kratz9/Scoreboard/Docs/System Overview.png

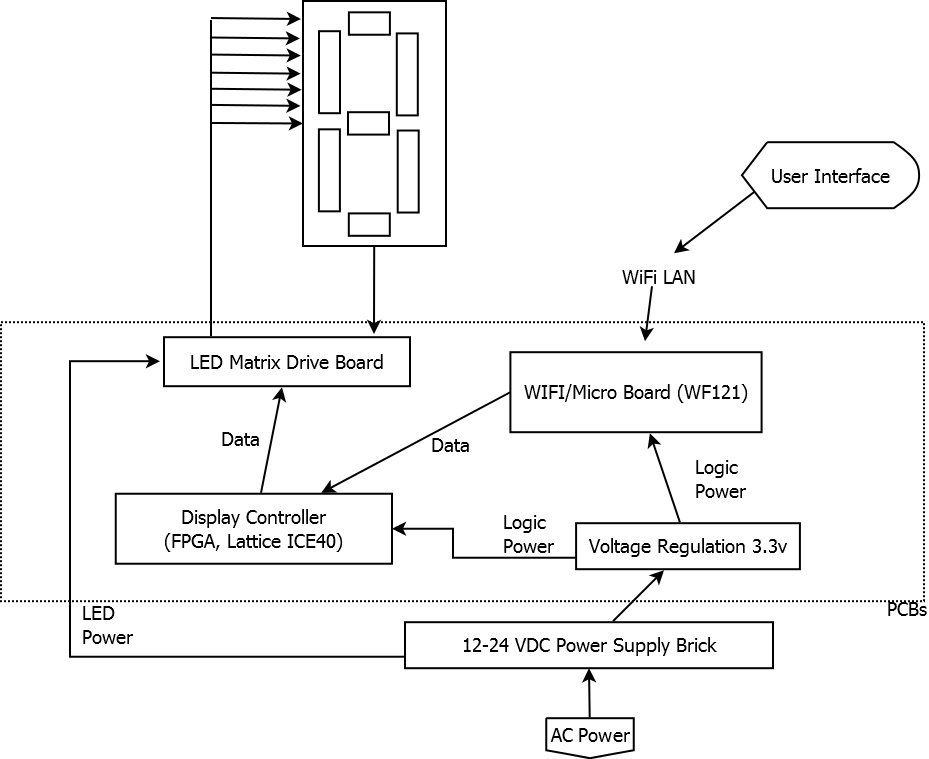
Docs/System Overview.png
