kratz9/Scoreboard/TestDisplay/TestDisplay.pdf

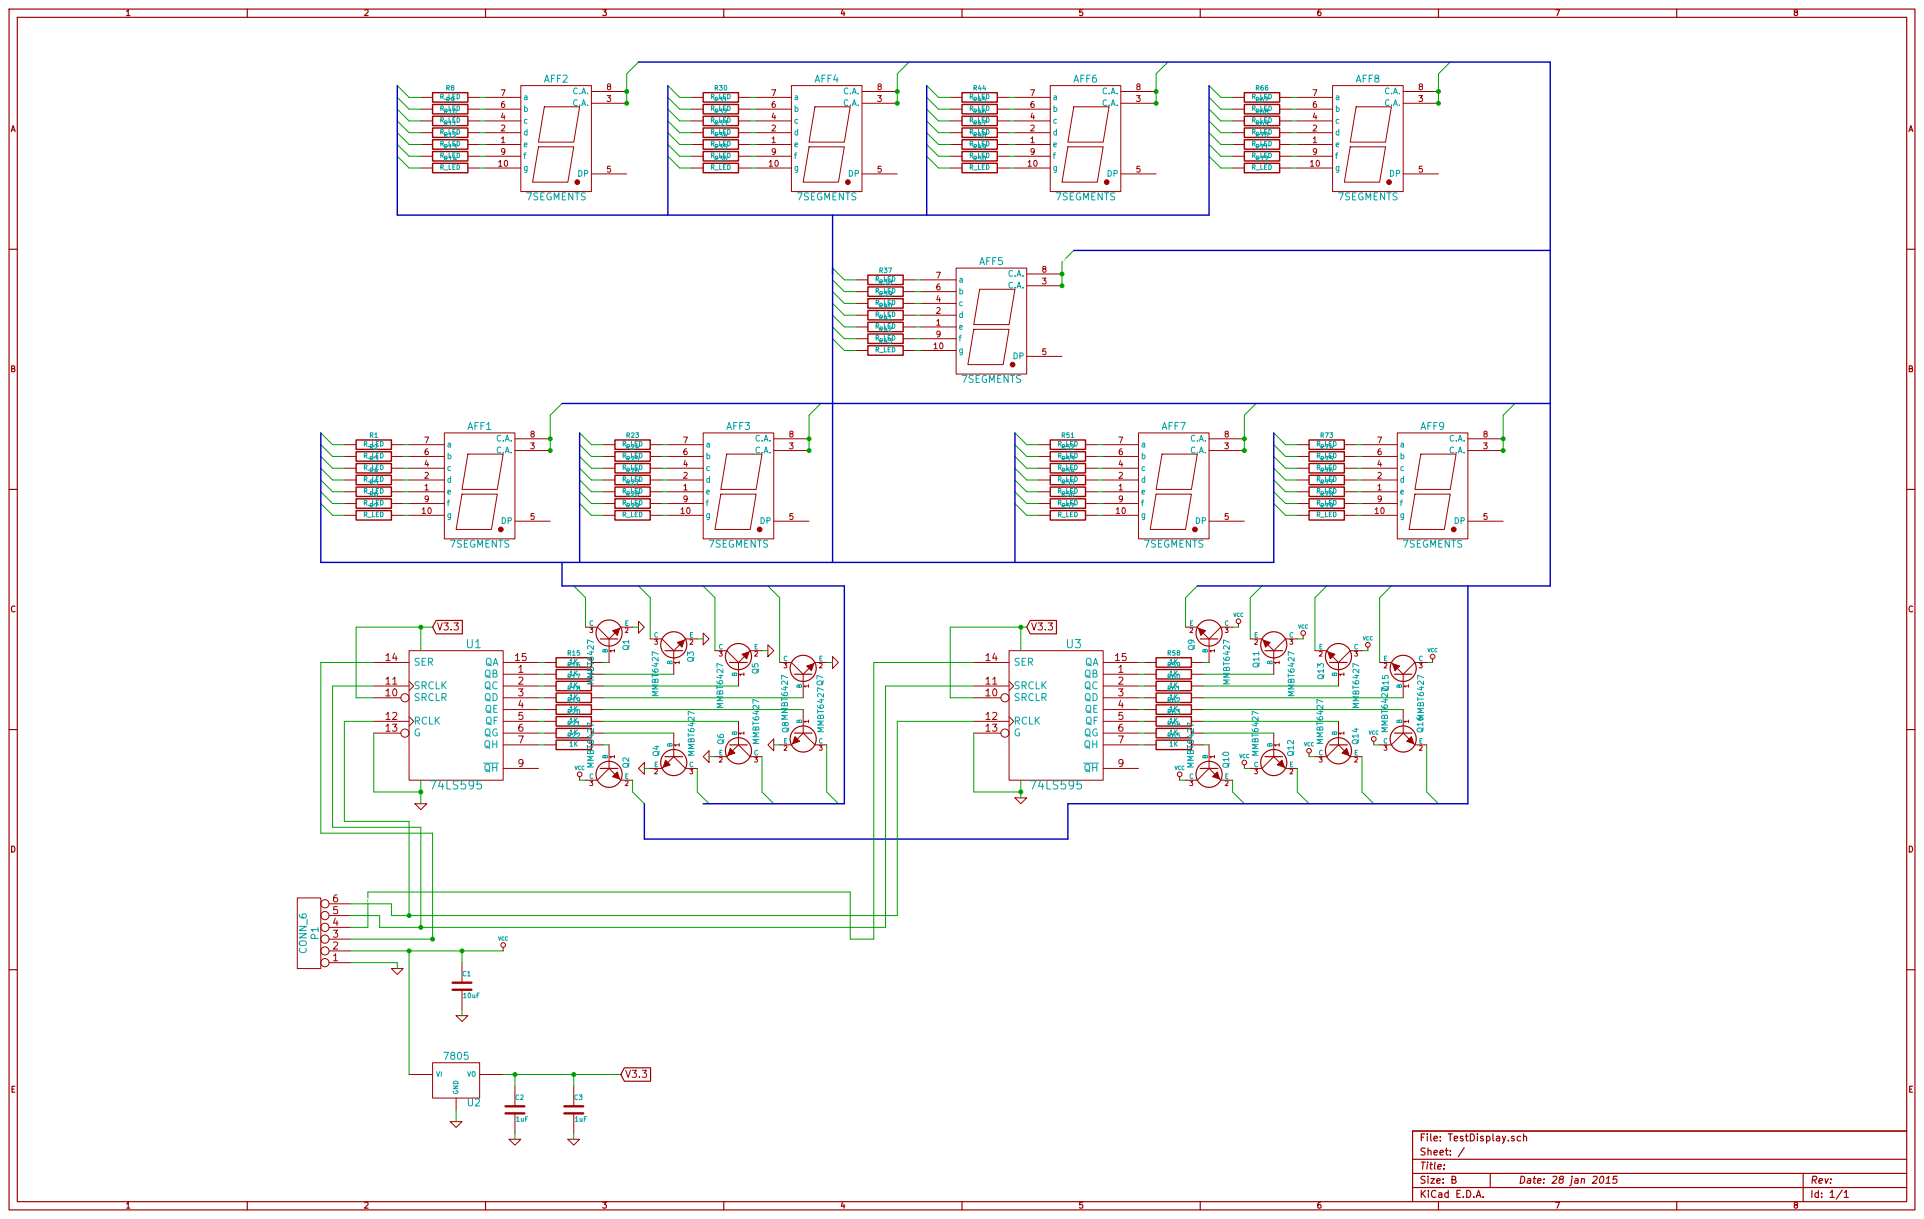
[picture p2: page 1]

Id: 1/1 Title: File: TestDisplay.sch
Sheet: /
