kratz9/Scoreboard/TestDigit/Digit.kicad_pcb

## KiCad design TestDigit/Digit.kicad_pcb (2015-02-24)

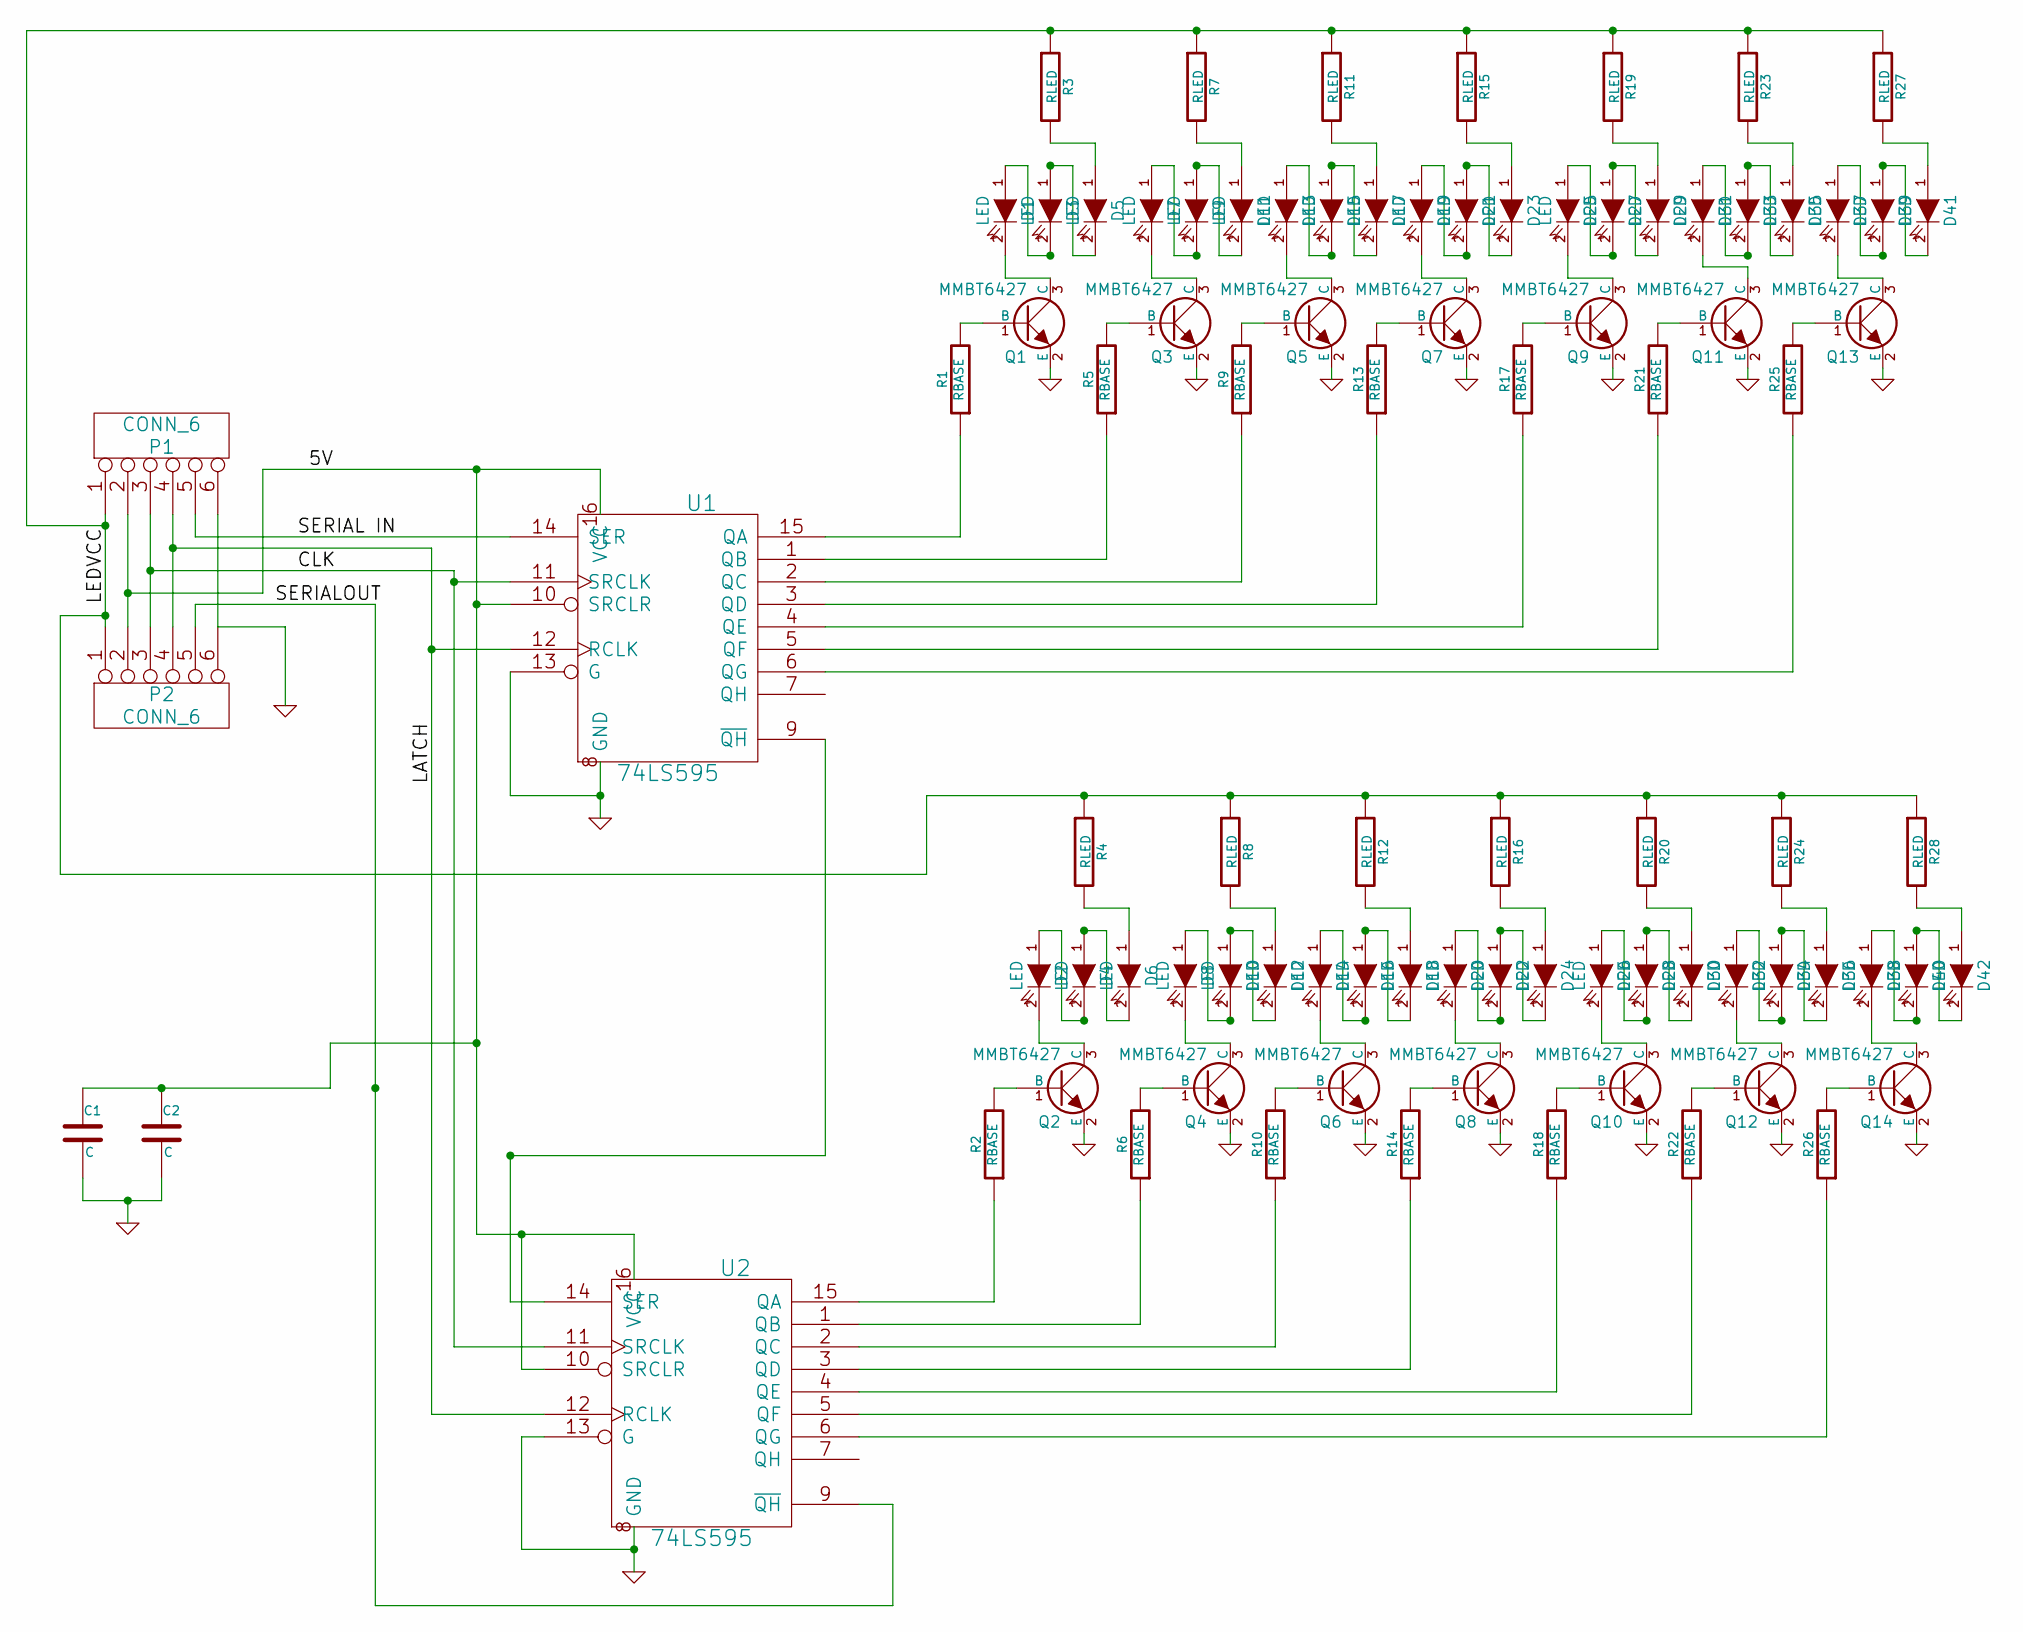
[picture p3: schematic Digit.sch]

Parts:
C1, C2: C
D1, D2, D3, D4, D5, D6, D7, D8, D9, D10, D11, D12, D13, D14, D15, D16, D17, D18, D19, D20, D21, D22, D23, D24, D25, D26, D27, D28, D29, D30, D31, D32, D33, D34, D35, D36, D37, D38, D39, D40, D41, D42: LED
P1, P2: CONN_6
Q1, Q2, Q3, Q4, Q5, Q6, Q7, Q8, Q9, Q10, Q11, Q12, Q13, Q14: MMBT6427
R1, R2, R5, R6, R9, R10, R13, R14, R17, R18, R21, R22, R25, R26: RBASE
R3, R4, R7, R8, R11, R12, R15, R16, R19, R20, R23, R24, R27, R28: RLED
U1, U2: 74LS595

Connections:
/5V: C1.1, C2.1, P1.2, P2.2, U1.10 (SRCLR), U1.16 (VCC), U2.10 (SRCLR), U2.16 (VCC)
/CLK: P1.3, P2.3, U1.11 (SRCLK), U2.11 (SRCLK)
/LATCH: P1.4, P2.4, U1.12 (RCLK), U2.12 (RCLK)
/LEDVCC: P1.1, P2.1, R3.1, R4.1, R7.1, R8.1, R11.1, R12.1, R15.1, R16.1, R19.1, R20.1, R23.1, R24.1, R27.1, R28.1
/SERIAL IN: P1.5, U1.14 (SER)
/SERIALOUT: P2.5, U2.9 (~QH)
GND: C1.2, C2.2, P1.6, P2.6, Q1.2 (E), Q2.2 (E), Q3.2 (E), Q4.2 (E), Q5.2 (E), Q6.2 (E), Q7.2 (E), Q8.2 (E), Q9.2 (E), Q10.2 (E), Q11.2 (E), Q12.2 (E), Q13.2 (E), Q14.2 (E), U1.8 (GND), U1.13 (G), U2.8 (GND), U2.13 (G)
unnamed: U1.9 (~QH), U2.14 (SER)
unnamed: D33.1 (A), D35.2 (K)
unnamed: D39.1 (A), D41.2 (K)
unnamed: Q2.1 (B), R2.2
unnamed: Q4.1 (B), R6.2
unnamed: Q6.1 (B), R10.2
unnamed: Q8.1 (B), R14.2
unnamed: D3.1 (A), D5.2 (K)
unnamed: R13.1, U1.3 (QD)
unnamed: R17.1, U1.4 (QE)
unnamed: R21.1, U1.5 (QF)
unnamed: R25.1, U1.6 (QG)
unnamed: Q10.1 (B), R18.2
unnamed: D7.1 (A), D9.2 (K)
unnamed: D9.1 (A), D11.2 (K)
unnamed: D15.1 (A), D17.2 (K)
unnamed: D21.1 (A), D23.2 (K)
unnamed: D27.1 (A), D29.2 (K)
unnamed: D16.1 (A), D18.2 (K)
unnamed: D22.1 (A), D24.2 (K)
unnamed: R26.1, U2.6 (QG)
unnamed: D28.1 (A), D30.2 (K)
unnamed: D34.1 (A), D36.2 (K)
unnamed: D40.1 (A), D42.2 (K)
unnamed: R10.1, U2.2 (QC)
unnamed: Q12.1 (B), R22.2
unnamed: Q14.1 (B), R26.2
unnamed: R2.1, U2.15 (QA)
unnamed: R6.1, U2.1 (QB)
unnamed: R14.1, U2.3 (QD)
unnamed: R18.1, U2.4 (QE)
unnamed: R22.1, U2.5 (QF)
unnamed: D10.1 (A), D12.2 (K)
unnamed: D12.1 (A), R8.2
unnamed: D14.2 (K), Q6.3 (C)
unnamed: D14.1 (A), D16.2 (K)
unnamed: D18.1 (A), R12.2
unnamed: D20.2 (K), Q8.3 (C)
unnamed: D20.1 (A), D22.2 (K)
unnamed: D4.1 (A), D6.2 (K)
unnamed: D41.1 (A), R27.2
unnamed: D2.2 (K), Q2.3 (C)
unnamed: D2.1 (A), D4.2 (K)
unnamed: D6.1 (A), R4.2
unnamed: D8.2 (K), Q4.3 (C)
unnamed: D8.1 (A), D10.2 (K)
unnamed: D38.2 (K), Q14.3 (C)
unnamed: D32.1 (A), D34.2 (K)
unnamed: D36.1 (A), R24.2
unnamed: D38.1 (A), D40.2 (K)
unnamed: D42.1 (A), R28.2
unnamed: D26.1 (A), D28.2 (K)
unnamed: D24.1 (A), R16.2
unnamed: D26.2 (K), Q10.3 (C)
unnamed: D30.1 (A), R20.2
unnamed: D32.2 (K), Q12.3 (C)
unnamed: D13.1 (A), D15.2 (K)
unnamed: D11.1 (A), R7.2
unnamed: D13.2 (K), Q5.3 (C)
unnamed: D17.1 (A), R11.2
unnamed: D19.2 (K), Q7.3 (C)
unnamed: D1.2 (K), Q1.3 (C)
unnamed: D1.1 (A), D3.2 (K)
unnamed: D19.1 (A), D21.2 (K)
unnamed: D5.1 (A), R3.2
unnamed: D7.2 (K), Q3.3 (C)
unnamed: D35.1 (A), R23.2
unnamed: D31.2 (K), Q11.3 (C)
unnamed: D31.1 (A), D33.2 (K)
unnamed: D37.2 (K), Q13.3 (C)
unnamed: D37.1 (A), D39.2 (K)
unnamed: D25.2 (K), Q9.3 (C)
unnamed: D23.1 (A), R15.2
unnamed: D25.1 (A), D27.2 (K)
unnamed: D29.1 (A), R19.2
unnamed: Q3.1 (B), R5.2
unnamed: Q5.1 (B), R9.2
unnamed: R9.1, U1.2 (QC)
unnamed: R1.1, U1.15 (QA)
unnamed: Q1.1 (B), R1.2
unnamed: Q13.1 (B), R25.2
unnamed: Q7.1 (B), R13.2
unnamed: Q9.1 (B), R17.2
unnamed: Q11.1 (B), R21.2
unnamed: R5.1, U1.1 (QB)

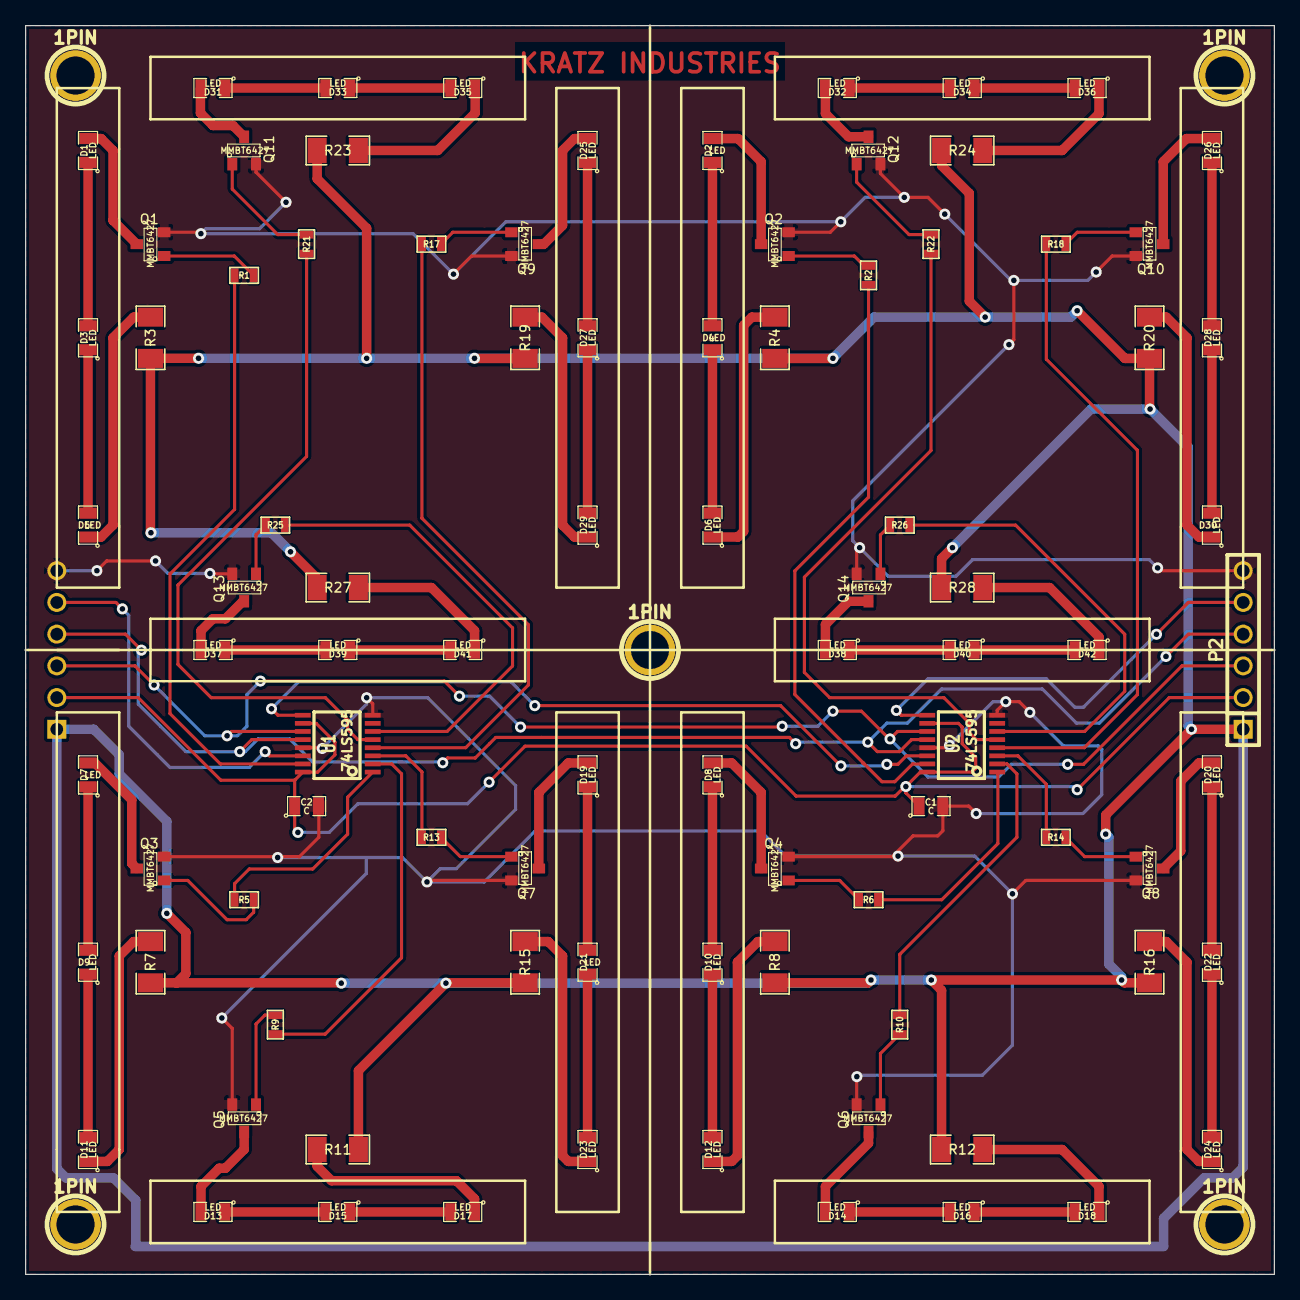
[picture p4: board Digit.kicad_pcb from above]

Board: 2 copper layers, 100.0 x 100.0 mm, 95 parts (1 on the bottom side), 92 nets.

Other parts of the board:
1PIN, 1PIN#2, 1PIN#3, 1PIN#4, 1PIN#5: P***; 1pin
