kratz9/Scoreboard/LED Drive/LED Drive.kicad_pcb

## KiCad design LED Drive/LED Drive.kicad_pcb (2015-02-01)

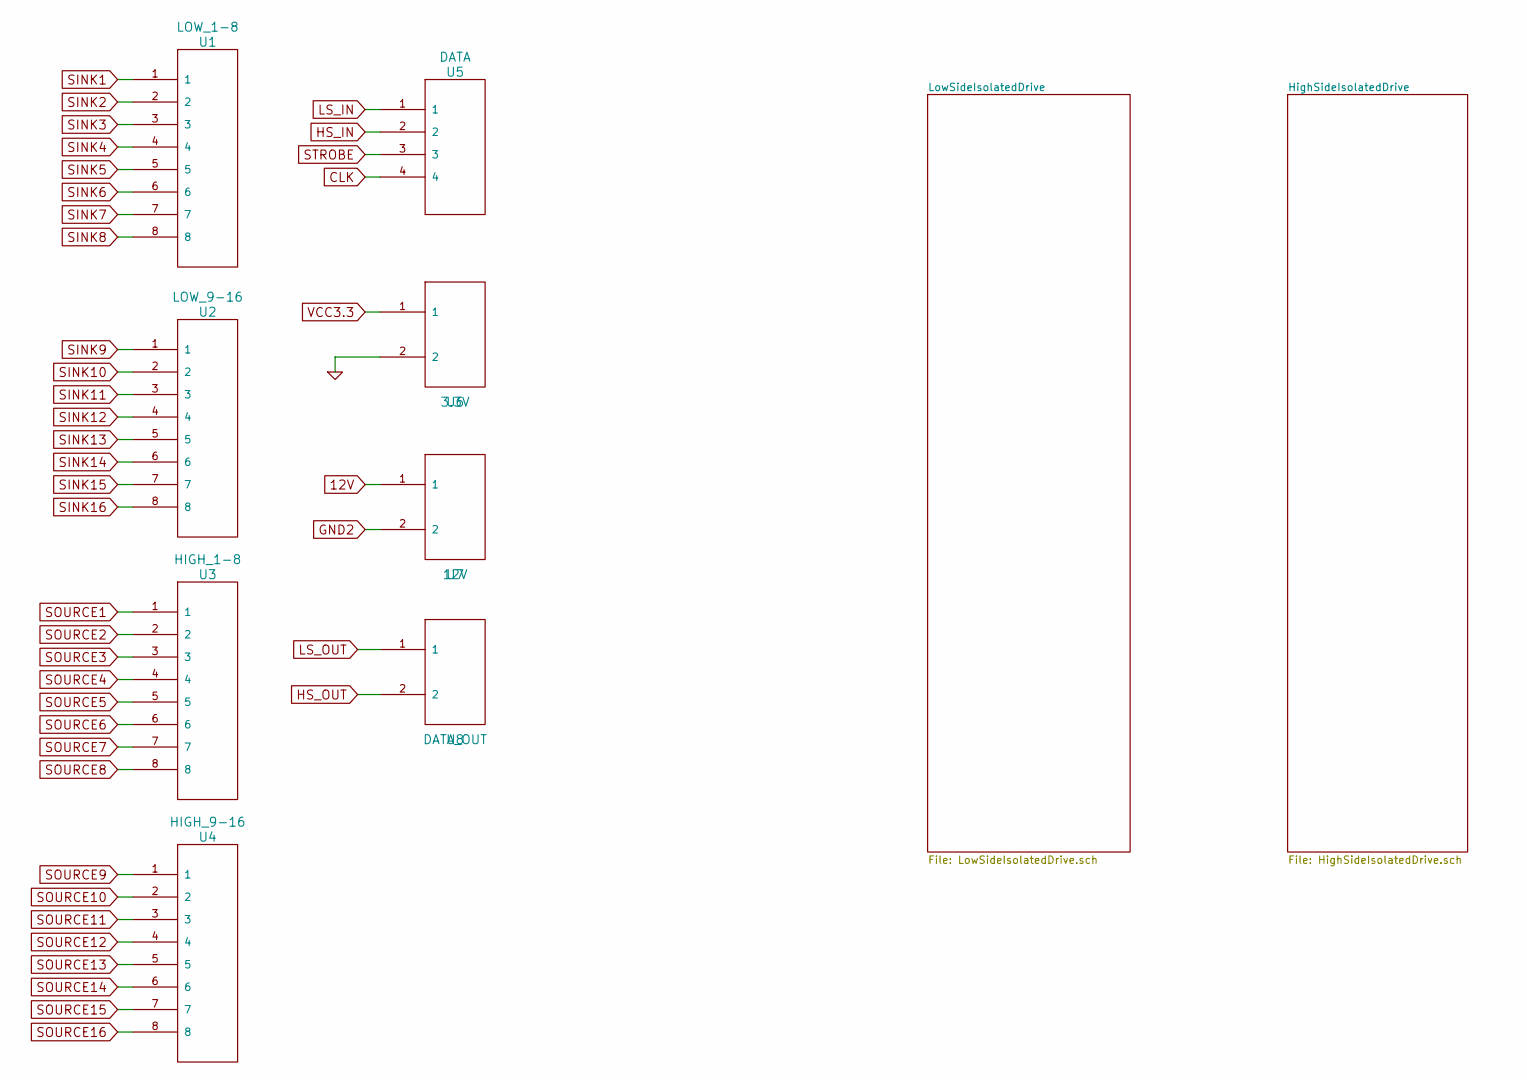
[picture p5: schematic LED Drive.sch]

Parts:
U1: LOW_1-8
U2: LOW_9-16
U3: HIGH_1-8
U4: HIGH_9-16
U5: DATA
U6: 3.3V
U7: 12V
U8: DATA_OUT

Connections:
12V: U7.1; also elsewhere on the board
CLK: U5.4; also elsewhere on the board
GND: U6.2; also elsewhere on the board
GND2: U7.2; also elsewhere on the board
HS_IN: U5.2; also elsewhere on the board
HS_OUT: U8.2; also elsewhere on the board
LS_IN: U5.1; also elsewhere on the board
LS_OUT: U8.1; also elsewhere on the board
SINK1: U1.1; also elsewhere on the board
SINK2: U1.2; also elsewhere on the board
SINK3: U1.3; also elsewhere on the board
SINK4: U1.4; also elsewhere on the board
SINK5: U1.5; also elsewhere on the board
SINK6: U1.6; also elsewhere on the board
SINK7: U1.7; also elsewhere on the board
SINK8: U1.8; also elsewhere on the board
SINK9: U2.1; also elsewhere on the board
SINK10: U2.2; also elsewhere on the board
SINK11: U2.3; also elsewhere on the board
SINK12: U2.4; also elsewhere on the board
SINK13: U2.5; also elsewhere on the board
SINK14: U2.6; also elsewhere on the board
SINK15: U2.7; also elsewhere on the board
SINK16: U2.8; also elsewhere on the board
SOURCE1: U3.1; also elsewhere on the board
SOURCE2: U3.2; also elsewhere on the board
SOURCE3: U3.3; also elsewhere on the board
SOURCE4: U3.4; also elsewhere on the board
SOURCE5: U3.5; also elsewhere on the board
SOURCE6: U3.6; also elsewhere on the board
SOURCE7: U3.7; also elsewhere on the board
SOURCE8: U3.8; also elsewhere on the board
SOURCE9: U4.1; also elsewhere on the board
SOURCE10: U4.2; also elsewhere on the board
SOURCE11: U4.3; also elsewhere on the board
SOURCE12: U4.4; also elsewhere on the board
SOURCE13: U4.5; also elsewhere on the board
SOURCE14: U4.6; also elsewhere on the board
SOURCE15: U4.7; also elsewhere on the board
SOURCE16: U4.8; also elsewhere on the board
STROBE: U5.3; also elsewhere on the board
VCC3.3: U6.1; also elsewhere on the board

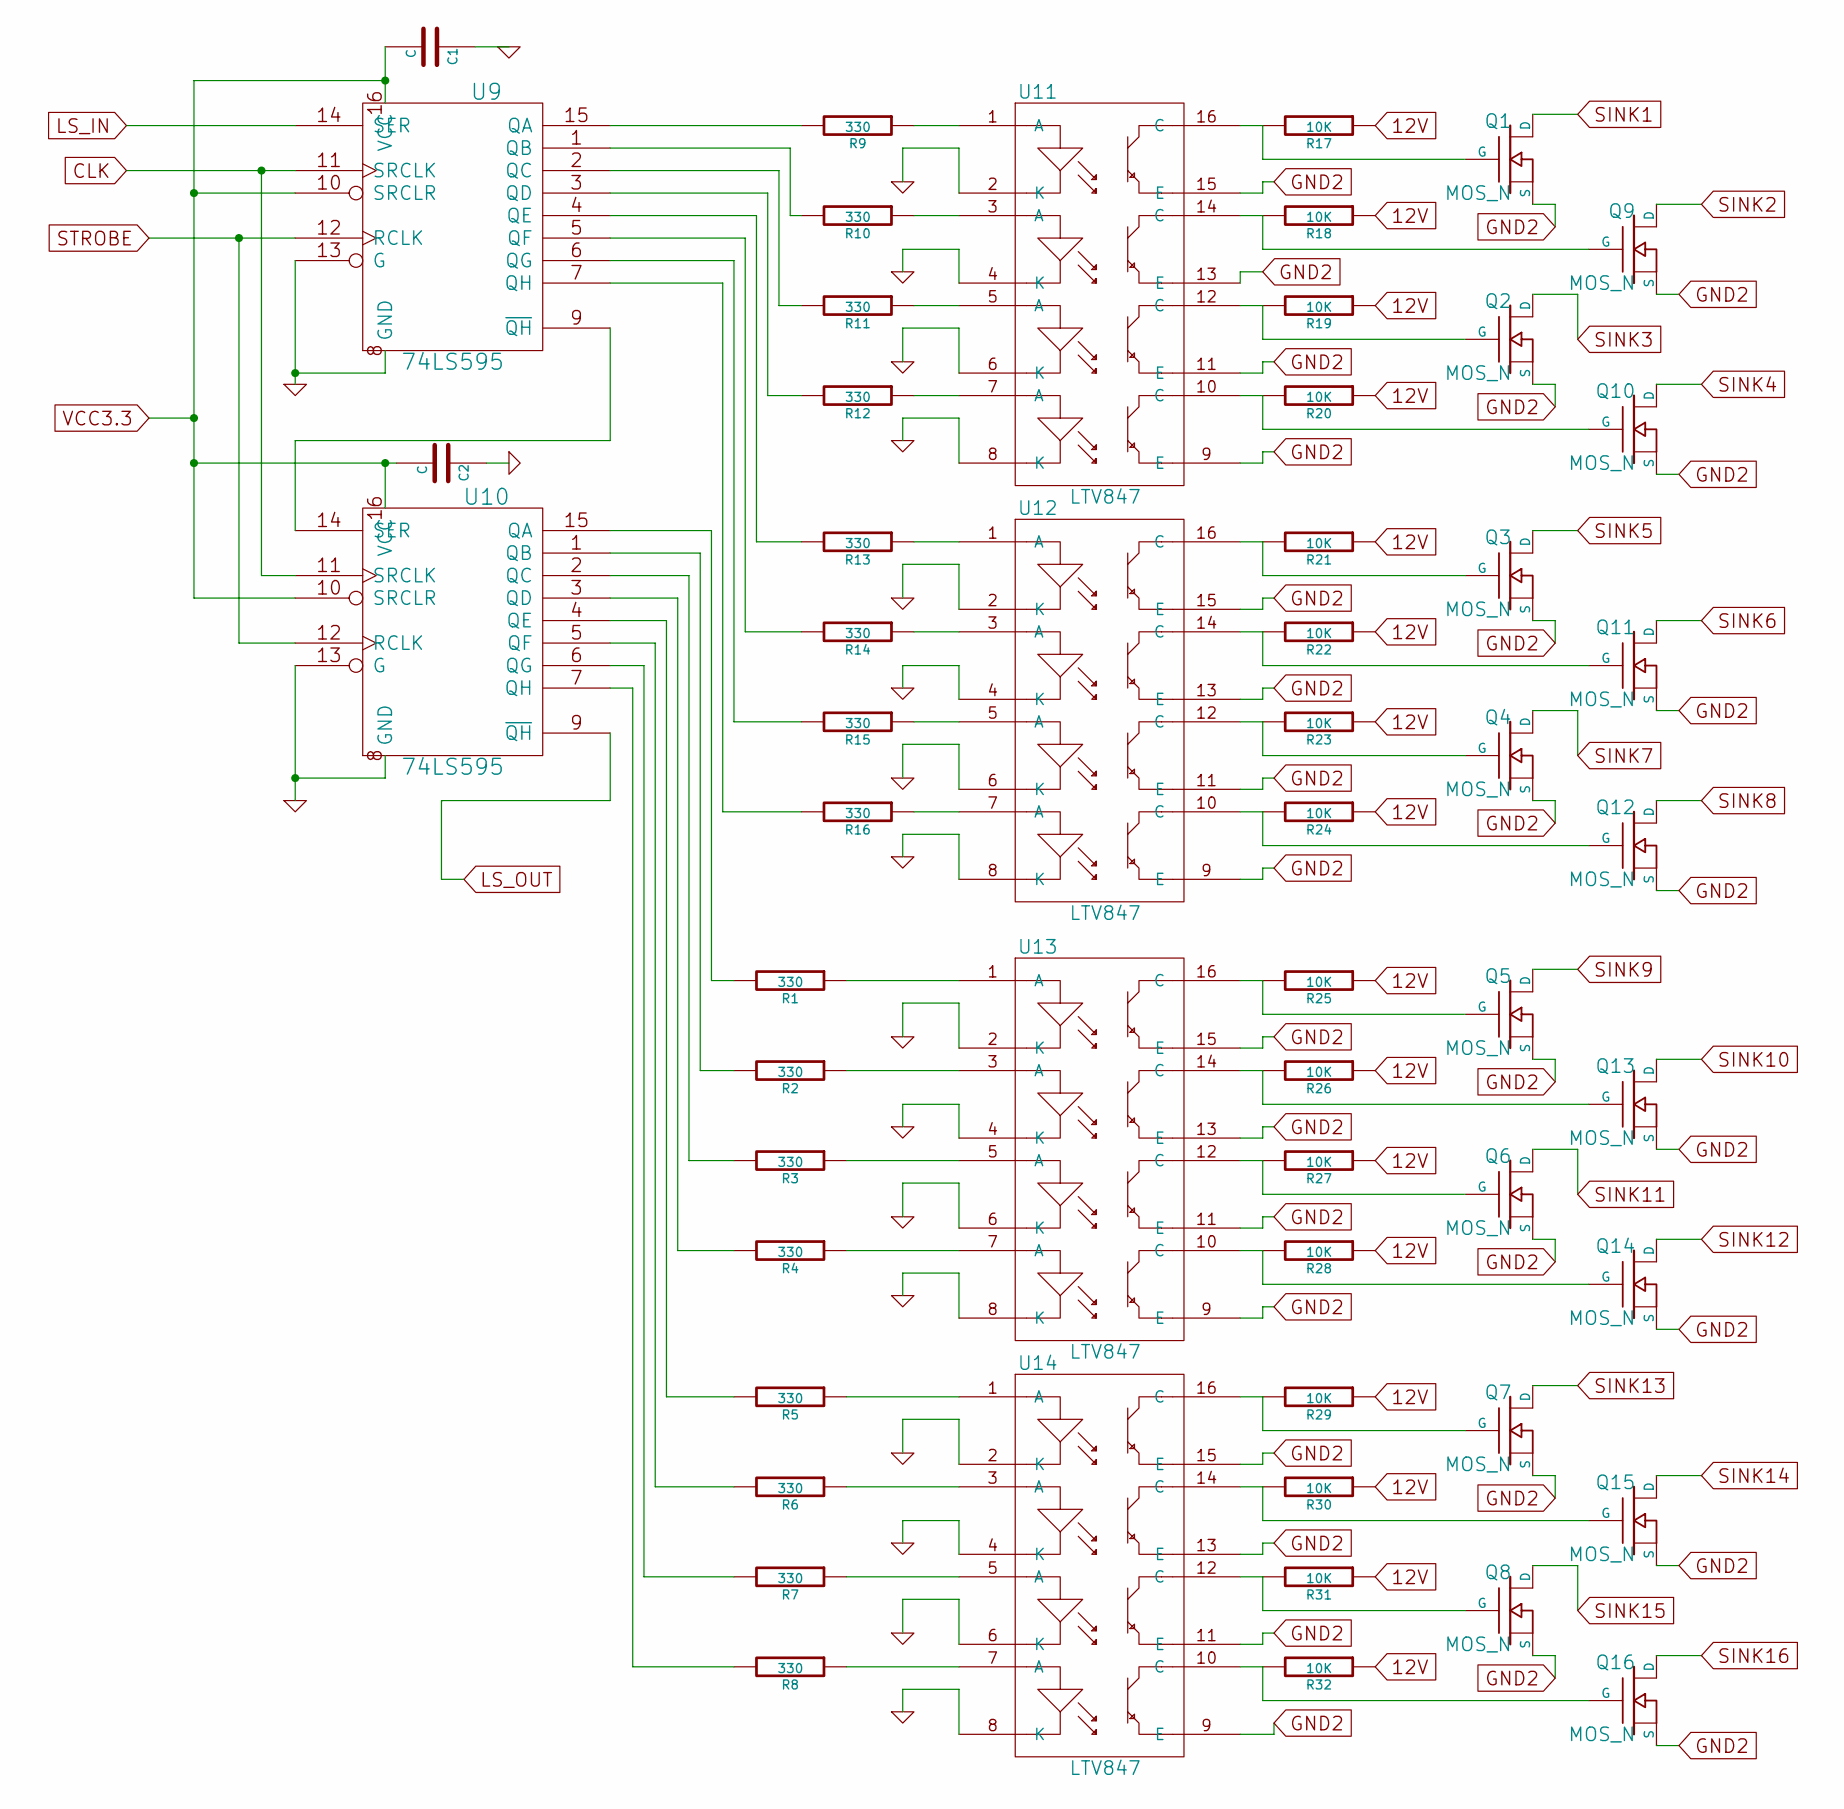
[picture p6: schematic LowSideIsolatedDrive.sch]

Parts:
C1, C2: C
Q1, Q2, Q3, Q4, Q5, Q6, Q7, Q8, Q9, Q10, Q11, Q12, Q13, Q14, Q15, Q16: MOS_N
R1, R2, R3, R4, R5, R6, R7, R8, R9, R10, R11, R12, R13, R14, R15, R16: 330
R17, R18, R19, R20, R21, R22, R23, R24, R25, R26, R27, R28, R29, R30, R31, R32: 10K
U9, U10: 74LS595
U11, U12, U13, U14: LTV847

Connections:
12V: R17.1, R18.1, R19.1, R20.1, R21.1, R22.1, R23.1, R24.1, R25.1, R26.1, R27.1, R28.1, R29.1, R30.1, R31.1, R32.1; also elsewhere on the board
CLK: U9.11 (SRCLK), U10.11 (SRCLK); also elsewhere on the board
GND: C1.1, C2.1, U9.8 (GND), U9.13 (G), U10.8 (GND), U10.13 (G), U11.2 (K), U11.4 (K), U11.6 (K), U11.8 (K), U12.2 (K), U12.4 (K), U12.6 (K), U12.8 (K), U13.2 (K), U13.4 (K), U13.6 (K), U13.8 (K), U14.2 (K), U14.4 (K), U14.6 (K), U14.8 (K); also elsewhere on the board
GND2: Q1.S, Q2.S, Q3.S, Q4.S, Q5.S, Q6.S, Q7.S, Q8.S, Q9.S, Q10.S, Q11.S, Q12.S, Q13.S, Q14.S, Q15.S, Q16.S, U11.9 (E), U11.11 (E), U11.13 (E), U11.15 (E), U12.9 (E), U12.11 (E), U12.13 (E), U12.15 (E), U13.9 (E), U13.11 (E), U13.13 (E), U13.15 (E), U14.9 (E), U14.11 (E), U14.13 (E), U14.15 (E); also elsewhere on the board
LS_IN: U9.14 (SER); also elsewhere on the board
LS_OUT: U10.9 (~QH); also elsewhere on the board
unnamed: Q13.G, R26.2, U13.14 (C)
unnamed: Q5.G, R25.2, U13.16 (C)
unnamed: R9.2, U9.15 (QA)
unnamed: Q4.G, R23.2, U12.12 (C)
unnamed: Q12.G, R24.2, U12.10 (C)
unnamed: R1.1, U13.1 (A)
unnamed: R2.1, U13.3 (A)
unnamed: R3.1, U13.5 (A)
unnamed: R4.1, U13.7 (A)
unnamed: Q7.G, R29.2, U14.16 (C)
unnamed: Q6.G, R27.2, U13.12 (C)
unnamed: Q14.G, R28.2, U13.10 (C)
unnamed: R5.1, U14.1 (A)
unnamed: R6.1, U14.3 (A)
unnamed: R7.1, U14.5 (A)
unnamed: R8.1, U14.7 (A)
unnamed: R12.2, U9.3 (QD)
unnamed: Q1.G, R17.2, U11.16 (C)
unnamed: Q9.G, R18.2, U11.14 (C)
unnamed: Q2.G, R19.2, U11.12 (C)
unnamed: R10.2, U9.1 (QB)
unnamed: R11.2, U9.2 (QC)
unnamed: Q3.G, R21.2, U12.16 (C)
unnamed: Q11.G, R22.2, U12.14 (C)
unnamed: R14.1, U12.3 (A)
unnamed: Q10.G, R20.2, U11.10 (C)
unnamed: R13.1, U12.1 (A)
unnamed: R15.1, U12.5 (A)
unnamed: R16.1, U12.7 (A)
unnamed: R13.2, U9.4 (QE)
unnamed: R14.2, U9.5 (QF)
unnamed: R15.2, U9.6 (QG)
unnamed: R16.2, U9.7 (QH)
unnamed: R1.2, U10.15 (QA)
unnamed: R2.2, U10.1 (QB)
unnamed: R3.2, U10.2 (QC)
unnamed: Q8.G, R31.2, U14.12 (C)
unnamed: Q15.G, R30.2, U14.14 (C)
unnamed: Q16.G, R32.2, U14.10 (C)
unnamed: R7.2, U10.6 (QG)
unnamed: R4.2, U10.3 (QD)
unnamed: R5.2, U10.4 (QE)
unnamed: R6.2, U10.5 (QF)
unnamed: R8.2, U10.7 (QH)
unnamed: U9.9 (~QH), U10.14 (SER)
unnamed: R12.1, U11.7 (A)
unnamed: R9.1, U11.1 (A)
unnamed: R10.1, U11.3 (A)
unnamed: R11.1, U11.5 (A)
SINK1: Q1.D; also elsewhere on the board
SINK2: Q9.D; also elsewhere on the board
SINK3: Q2.D; also elsewhere on the board
SINK4: Q10.D; also elsewhere on the board
SINK5: Q3.D; also elsewhere on the board
SINK6: Q11.D; also elsewhere on the board
SINK7: Q4.D; also elsewhere on the board
SINK8: Q12.D; also elsewhere on the board
SINK9: Q5.D; also elsewhere on the board
SINK10: Q13.D; also elsewhere on the board
SINK11: Q6.D; also elsewhere on the board
SINK12: Q14.D; also elsewhere on the board
SINK13: Q7.D; also elsewhere on the board
SINK14: Q15.D; also elsewhere on the board
SINK15: Q8.D; also elsewhere on the board
SINK16: Q16.D; also elsewhere on the board
STROBE: U9.12 (RCLK), U10.12 (RCLK); also elsewhere on the board
VCC3.3: C1.2, C2.2, U9.10 (SRCLR), U9.16 (VCC), U10.10 (SRCLR), U10.16 (VCC); also elsewhere on the board

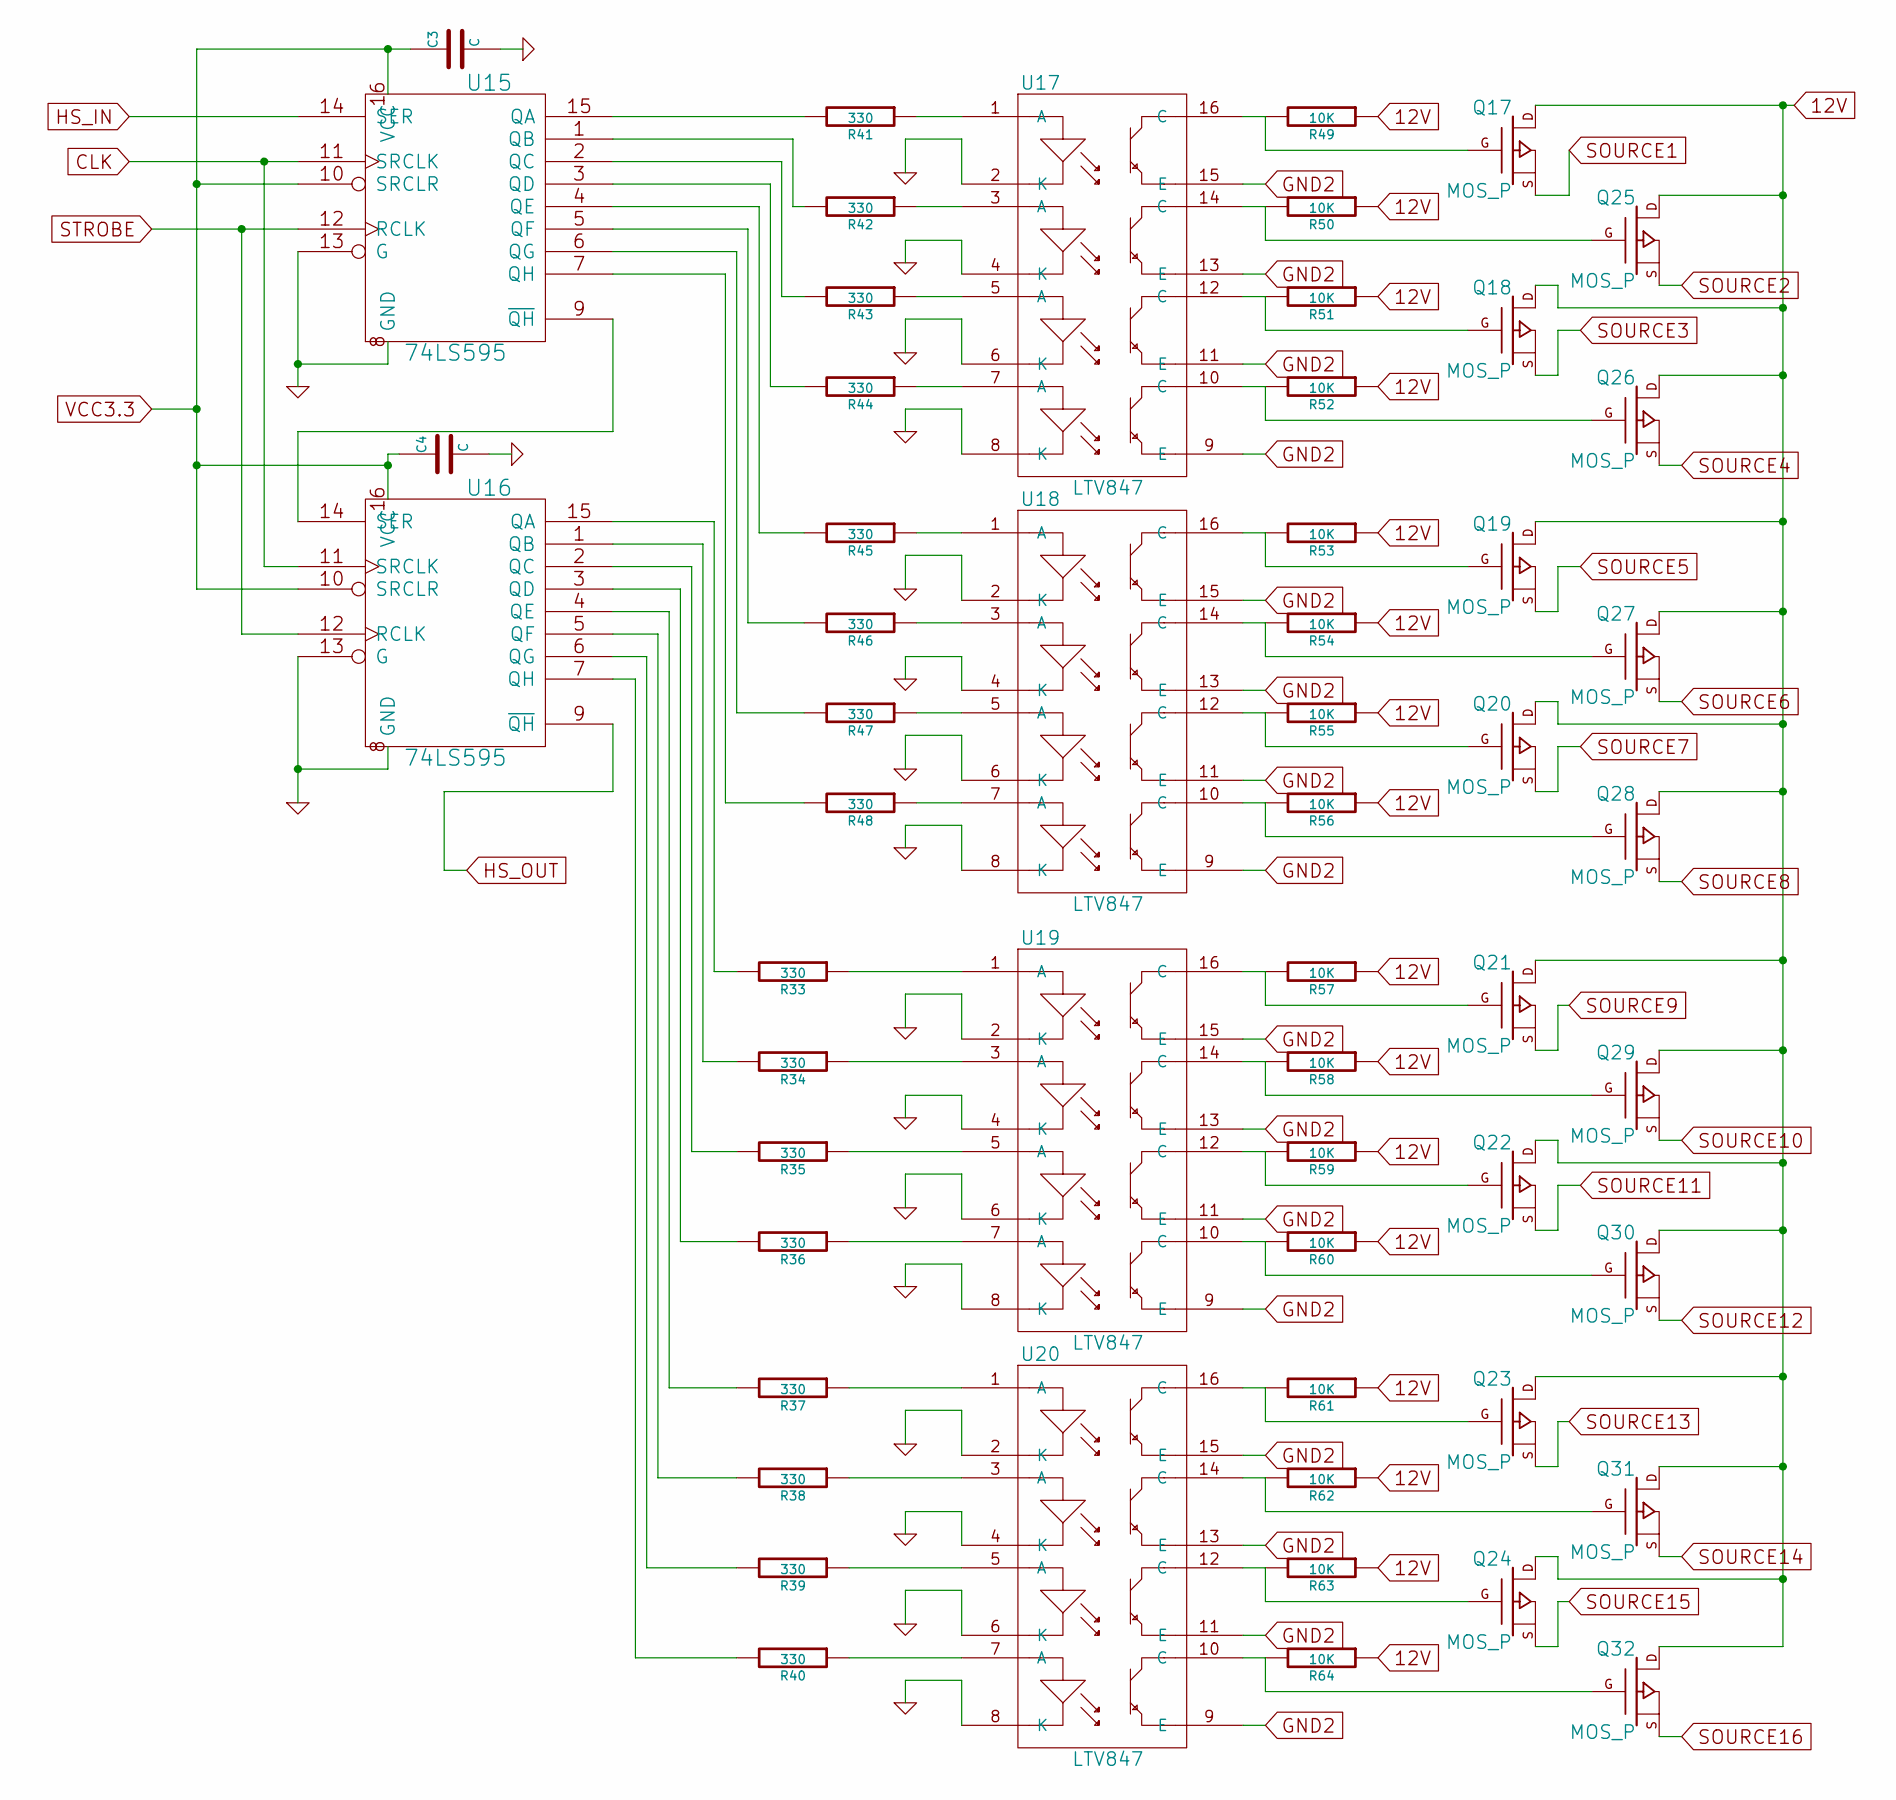
[picture p7: schematic HighSideIsolatedDrive.sch]

Parts:
C3, C4: C
Q17, Q18, Q19, Q20, Q21, Q22, Q23, Q24, Q25, Q26, Q27, Q28, Q29, Q30, Q31, Q32: MOS_P
R33, R34, R35, R36, R37, R38, R39, R40, R41, R42, R43, R44, R45, R46, R47, R48: 330
R49, R50, R51, R52, R53, R54, R55, R56, R57, R58, R59, R60, R61, R62, R63, R64: 10K
U15, U16: 74LS595
U17, U18, U19, U20: LTV847

Connections:
12V: Q17.D, Q18.D, Q19.D, Q20.D, Q21.D, Q22.D, Q23.D, Q24.D, Q25.D, Q26.D, Q27.D, Q28.D, Q29.D, Q30.D, Q31.D, Q32.D, R49.1, R50.1, R51.1, R52.1, R53.1, R54.1, R55.1, R56.1, R57.1, R58.1, R59.1, R60.1, R61.1, R62.1, R63.1, R64.1; also elsewhere on the board
CLK: U15.11 (SRCLK), U16.11 (SRCLK); also elsewhere on the board
GND: C3.2, C4.2, U15.8 (GND), U15.13 (G), U16.8 (GND), U16.13 (G), U17.2 (K), U17.4 (K), U17.6 (K), U17.8 (K), U18.2 (K), U18.4 (K), U18.6 (K), U18.8 (K), U19.2 (K), U19.4 (K), U19.6 (K), U19.8 (K), U20.2 (K), U20.4 (K), U20.6 (K), U20.8 (K); also elsewhere on the board
GND2: U17.9 (E), U17.11 (E), U17.13 (E), U17.15 (E), U18.9 (E), U18.11 (E), U18.13 (E), U18.15 (E), U19.9 (E), U19.11 (E), U19.13 (E), U19.15 (E), U20.9 (E), U20.11 (E), U20.13 (E), U20.15 (E); also elsewhere on the board
HS_IN: U15.14 (SER); also elsewhere on the board
HS_OUT: U16.9 (~QH); also elsewhere on the board
unnamed: Q23.G, R61.2, U20.16 (C)
unnamed: Q31.G, R62.2, U20.14 (C)
unnamed: Q22.G, R59.2, U19.12 (C)
unnamed: Q30.G, R60.2, U19.10 (C)
unnamed: R37.1, U20.1 (A)
unnamed: R38.1, U20.3 (A)
unnamed: R39.1, U20.5 (A)
unnamed: R40.1, U20.7 (A)
unnamed: R34.2, U16.1 (QB)
unnamed: R47.2, U15.6 (QG)
unnamed: R48.2, U15.7 (QH)
unnamed: R33.2, U16.15 (QA)
unnamed: R35.2, U16.2 (QC)
unnamed: R36.2, U16.3 (QD)
unnamed: Q32.G, R64.2, U20.10 (C)
unnamed: Q24.G, R63.2, U20.12 (C)
unnamed: R45.2, U15.4 (QE)
unnamed: R46.2, U15.5 (QF)
unnamed: Q19.G, R53.2, U18.16 (C)
unnamed: Q27.G, R54.2, U18.14 (C)
unnamed: R48.1, U18.7 (A)
unnamed: R45.1, U18.1 (A)
unnamed: R46.1, U18.3 (A)
unnamed: R47.1, U18.5 (A)
unnamed: Q20.G, R55.2, U18.12 (C)
unnamed: Q21.G, R57.2, U19.16 (C)
unnamed: Q29.G, R58.2, U19.14 (C)
unnamed: R34.1, U19.3 (A)
unnamed: Q28.G, R56.2, U18.10 (C)
unnamed: R33.1, U19.1 (A)
unnamed: R35.1, U19.5 (A)
unnamed: R36.1, U19.7 (A)
unnamed: Q25.G, R50.2, U17.14 (C)
unnamed: Q18.G, R51.2, U17.12 (C)
unnamed: R40.2, U16.7 (QH)
unnamed: R37.2, U16.4 (QE)
unnamed: R38.2, U16.5 (QF)
unnamed: R39.2, U16.6 (QG)
unnamed: Q17.G, R49.2, U17.16 (C)
unnamed: U15.9 (~QH), U16.14 (SER)
unnamed: Q26.G, R52.2, U17.10 (C)
unnamed: R41.1, U17.1 (A)
unnamed: R41.2, U15.15 (QA)
unnamed: R42.1, U17.3 (A)
unnamed: R42.2, U15.1 (QB)
unnamed: R43.1, U17.5 (A)
unnamed: R43.2, U15.2 (QC)
unnamed: R44.1, U17.7 (A)
unnamed: R44.2, U15.3 (QD)
SOURCE1: Q17.S; also elsewhere on the board
SOURCE2: Q25.S; also elsewhere on the board
SOURCE3: Q18.S; also elsewhere on the board
SOURCE4: Q26.S; also elsewhere on the board
SOURCE5: Q19.S; also elsewhere on the board
SOURCE6: Q27.S; also elsewhere on the board
SOURCE7: Q20.S; also elsewhere on the board
SOURCE8: Q28.S; also elsewhere on the board
SOURCE9: Q21.S; also elsewhere on the board
SOURCE10: Q29.S; also elsewhere on the board
SOURCE11: Q22.S; also elsewhere on the board
SOURCE12: Q30.S; also elsewhere on the board
SOURCE13: Q23.S; also elsewhere on the board
SOURCE14: Q31.S; also elsewhere on the board
SOURCE15: Q24.S; also elsewhere on the board
SOURCE16: Q32.S; also elsewhere on the board
STROBE: U15.12 (RCLK), U16.12 (RCLK); also elsewhere on the board
VCC3.3: C3.1, C4.1, U15.10 (SRCLR), U15.16 (VCC), U16.10 (SRCLR), U16.16 (VCC); also elsewhere on the board

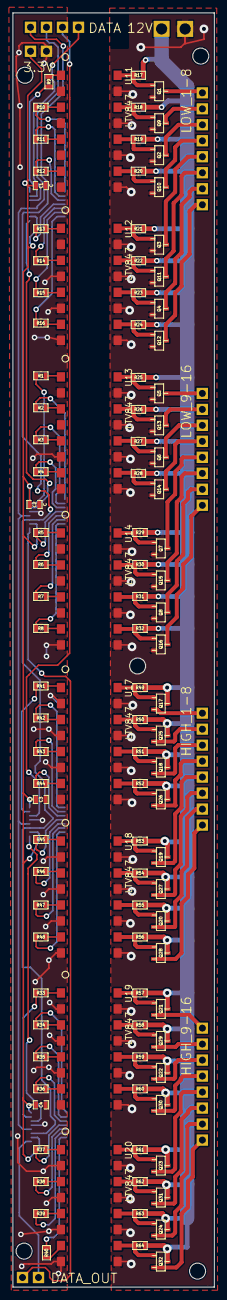
[picture p8: board LED Drive.kicad_pcb from above]

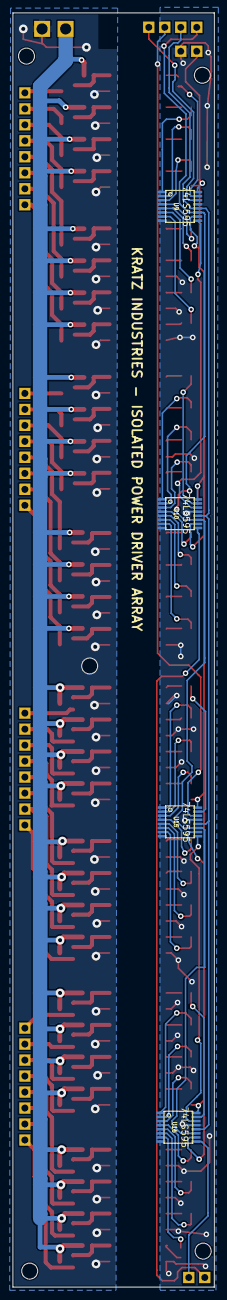
[picture p9: board LED Drive.kicad_pcb from below]

Board: 2 copper layers, 32.0 x 202.4 mm, 125 parts (4 on the bottom side), 140 nets.

Other parts of the board:
HOLE: VAL**; HOLE
HOLE#2, HOLE#3, HOLE#4, HOLE#5: VAL**; HOLE
