kratz9/Scoreboard/TestDisplay/TestDisplay.kicad_pcb

## KiCad design TestDisplay/TestDisplay.kicad_pcb (2015-02-01)

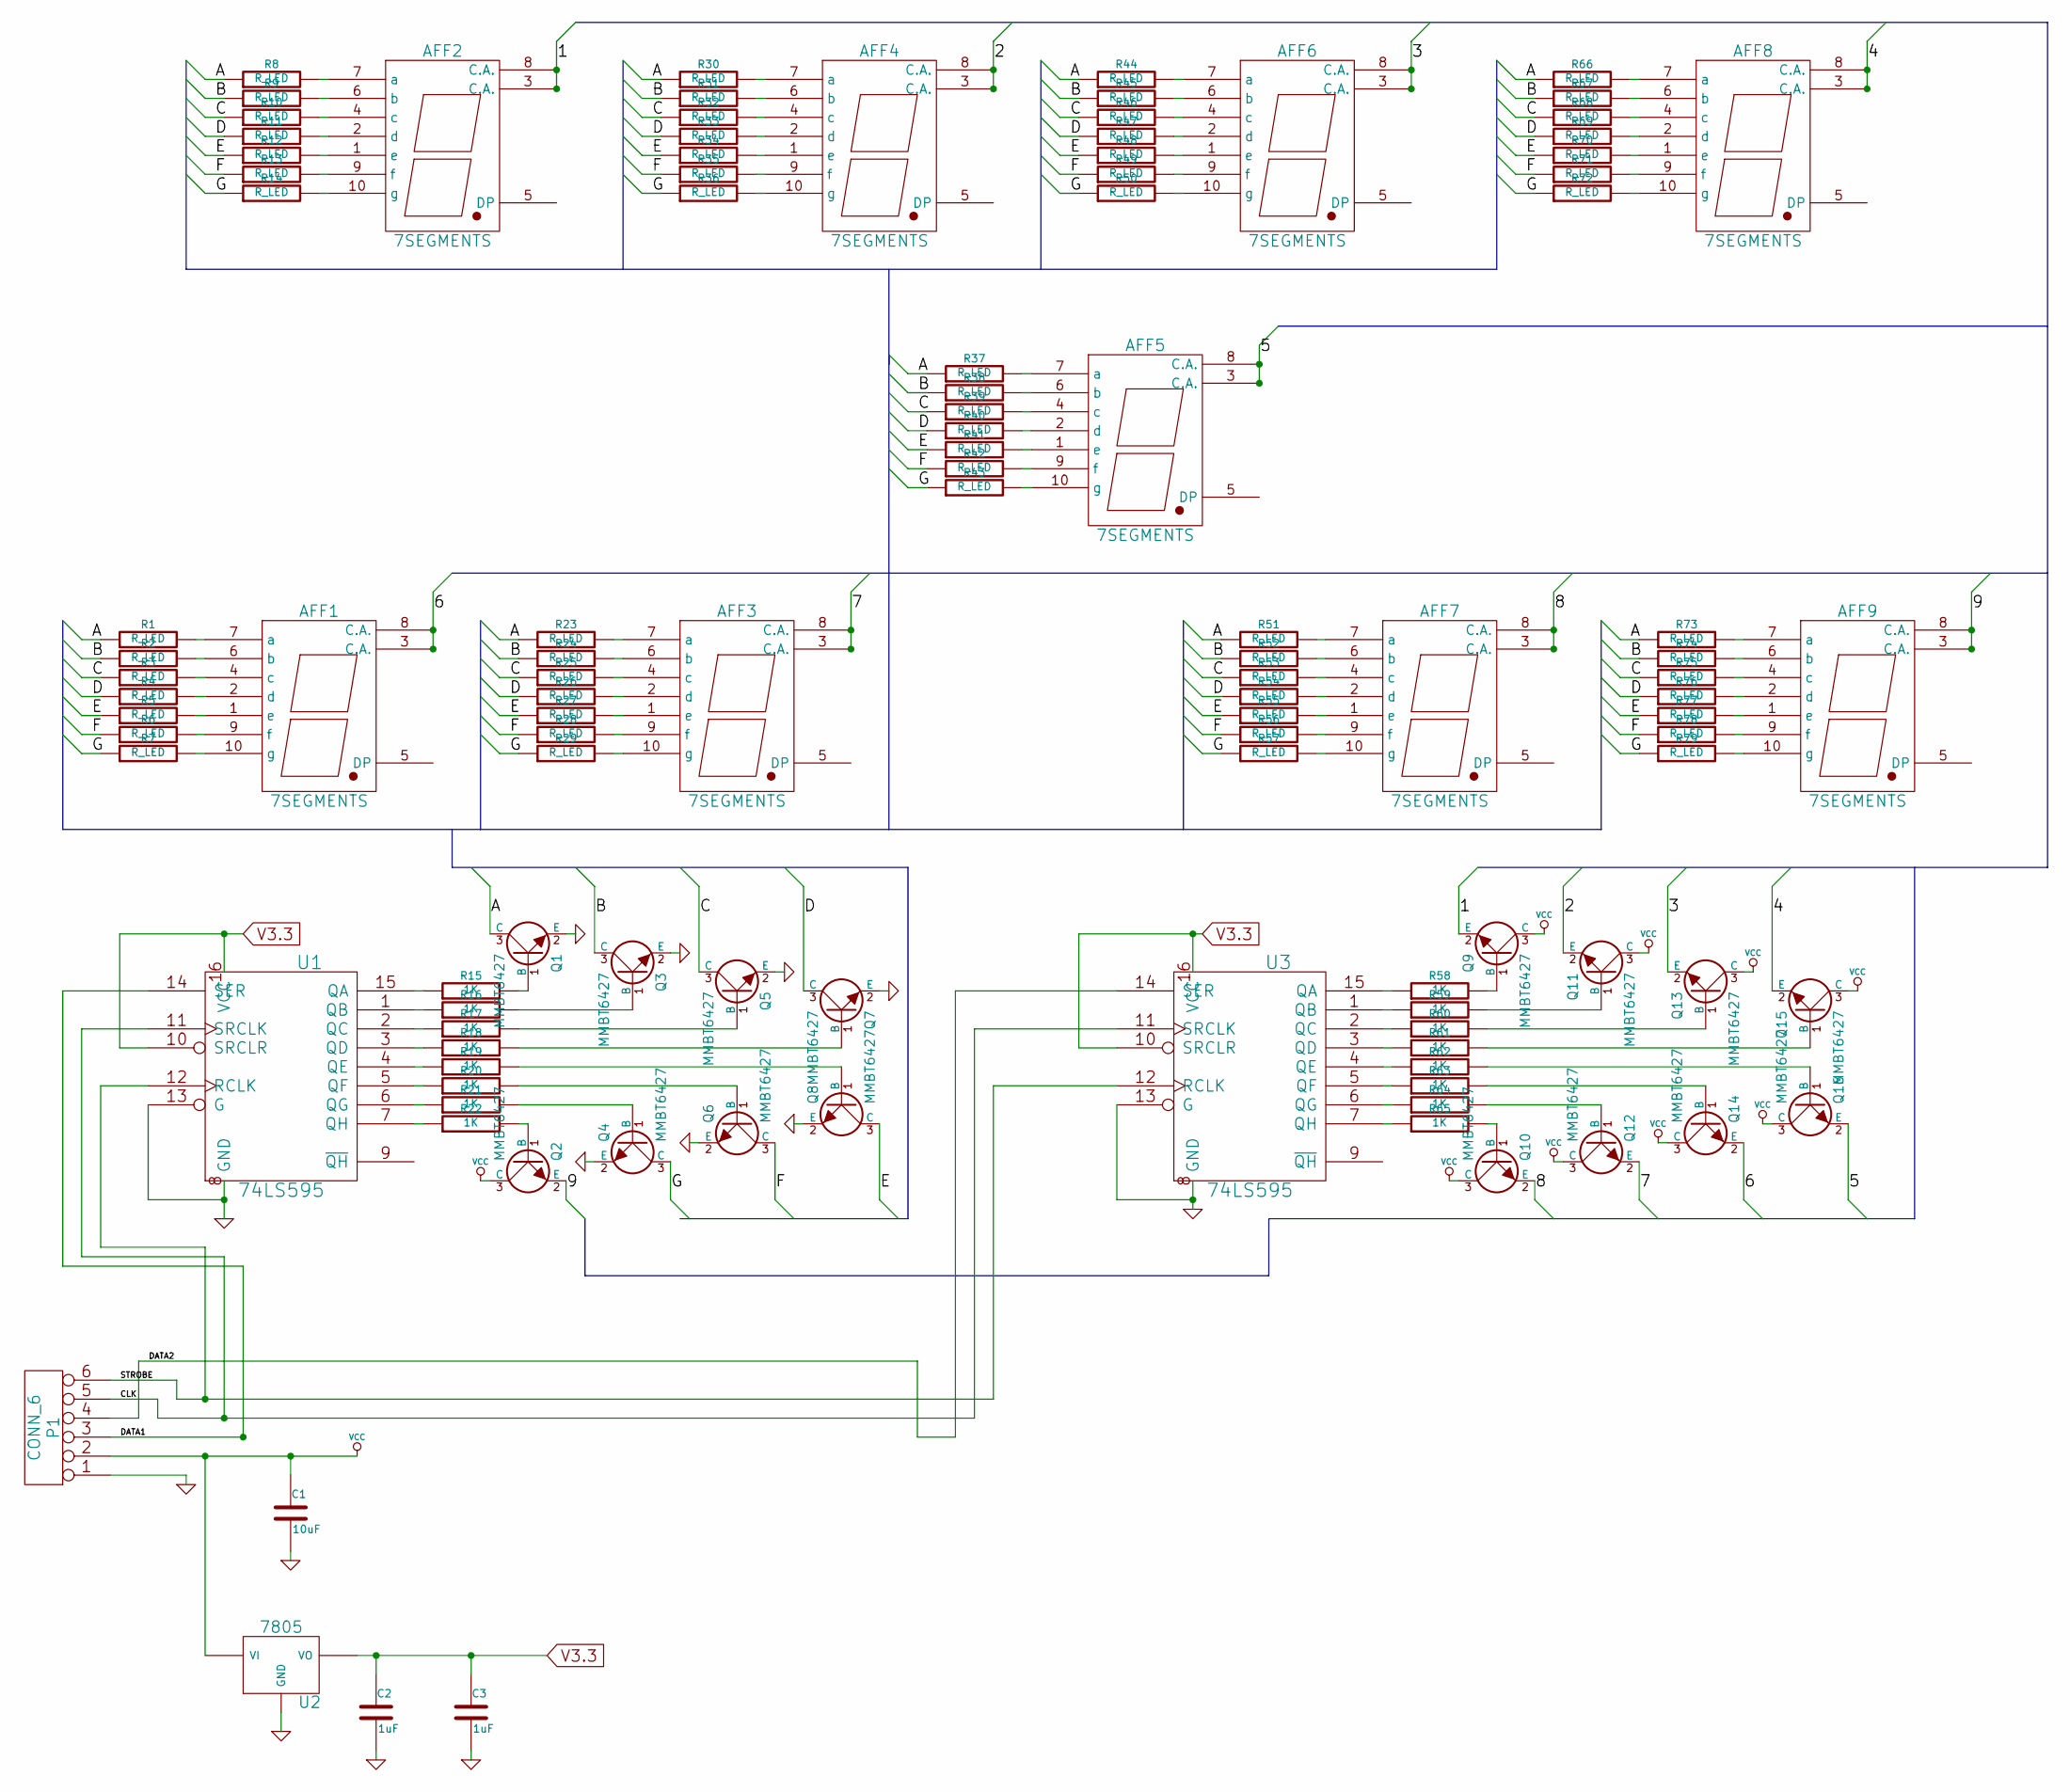
[picture p10: schematic TestDisplay.sch]

Parts:
AFF1, AFF2, AFF3, AFF4, AFF5, AFF6, AFF7, AFF8, AFF9: 7SEGMENTS
C1: 10uF
C2, C3: 1uF
P1: CONN_6
Q1, Q2, Q3, Q4, Q5, Q6, Q7, Q8, Q9, Q10, Q11, Q12, Q13, Q14, Q15, Q16: MMBT6427
R1, R2, R3, R4, R5, R6, R7, R8, R9, R10, R11, R12, R13, R14, R23, R24, R25, R26, R27, R28, R29, R30, R31, R32, R33, R34, R35, R36, R37, R38, R39, R40, R41, R42, R43, R44, R45, R46, R47, R48, R49, R50, R51, R52, R53, R54, R55, R56, R57, R66, R67, R68, R69, R70, R71, R72, R73, R74, R75, R76, R77, R78, R79: R_LED
R15, R16, R17, R18, R19, R20, R21, R22, R58, R59, R60, R61, R62, R63, R64, R65: 1K
U1, U3: 74LS595
U2: 7805

Connections:
/1: AFF2.3 (C.A.), AFF2.8 (C.A.), Q9.2 (E)
/2: AFF4.3 (C.A.), AFF4.8 (C.A.), Q11.2 (E)
/3: AFF6.3 (C.A.), AFF6.8 (C.A.), Q13.2 (E)
/4: AFF8.3 (C.A.), AFF8.8 (C.A.), Q15.2 (E)
/5: AFF5.3 (C.A.), AFF5.8 (C.A.), Q16.2 (E)
/6: AFF1.3 (C.A.), AFF1.8 (C.A.), Q14.2 (E)
/7: AFF3.3 (C.A.), AFF3.8 (C.A.), Q12.2 (E)
/8: AFF7.3 (C.A.), AFF7.8 (C.A.), Q10.2 (E)
/9: AFF9.3 (C.A.), AFF9.8 (C.A.), Q2.2 (E)
/A: Q1.3 (C), R1.1, R8.1, R23.1, R30.1, R37.1, R44.1, R51.1, R66.1, R73.1
/B: Q3.3 (C), R2.1, R9.1, R24.1, R31.1, R38.1, R45.1, R52.1, R67.1, R74.1
/C: Q5.3 (C), R3.1, R10.1, R25.1, R32.1, R39.1, R46.1, R53.1, R68.1, R75.1
/CLK: P1.5, U1.11 (SRCLK), U3.11 (SRCLK)
/D: Q7.3 (C), R4.1, R11.1, R26.1, R33.1, R40.1, R47.1, R54.1, R69.1, R76.1
/DATA1: P1.3, U1.14 (SER)
/DATA2: P1.4, U3.14 (SER)
/E: Q8.3 (C), R5.1, R12.1, R27.1, R34.1, R41.1, R48.1, R55.1, R70.1, R77.1
/F: Q6.3 (C), R6.1, R13.1, R28.1, R35.1, R42.1, R49.1, R56.1, R71.1, R78.1
/G: Q4.3 (C), R7.1, R14.1, R29.1, R36.1, R43.1, R50.1, R57.1, R72.1, R79.1
/STROBE: P1.6, U1.12 (RCLK), U3.12 (RCLK)
GND: C1.2, C2.2, C3.2, P1.1, Q1.2 (E), Q3.2 (E), Q4.2 (E), Q5.2 (E), Q6.2 (E), Q7.2 (E), Q8.2 (E), U1.8 (GND), U1.13 (G), U2.1, U2.GND, U3.8 (GND), U3.13 (G)
unnamed: AFF8.7 (a), R66.2
unnamed: AFF8.6 (b), R67.2
unnamed: AFF8.4 (c), R68.2
unnamed: AFF8.2 (d), R69.2
unnamed: AFF8.1 (e), R70.2
unnamed: AFF8.9 (f), R71.2
unnamed: AFF8.10 (g), R72.2
unnamed: AFF7.2 (d), R54.2
unnamed: AFF7.1 (e), R55.2
unnamed: AFF7.9 (f), R56.2
unnamed: AFF7.10 (g), R57.2
unnamed: AFF9.7 (a), R73.2
unnamed: AFF9.6 (b), R74.2
unnamed: AFF9.4 (c), R75.2
unnamed: AFF9.2 (d), R76.2
unnamed: AFF9.1 (e), R77.2
unnamed: AFF9.9 (f), R78.2
unnamed: AFF9.10 (g), R79.2
unnamed: AFF7.4 (c), R53.2
unnamed: AFF1.10 (g), R7.2
unnamed: AFF5.4 (c), R39.2
unnamed: AFF5.2 (d), R40.2
unnamed: AFF5.1 (e), R41.2
unnamed: AFF5.9 (f), R42.2
unnamed: AFF5.10 (g), R43.2
unnamed: AFF1.7 (a), R1.2
unnamed: AFF1.6 (b), R2.2
unnamed: AFF1.4 (c), R3.2
unnamed: AFF1.2 (d), R4.2
unnamed: AFF1.1 (e), R5.2
unnamed: AFF1.9 (f), R6.2
unnamed: AFF3.7 (a), R23.2
unnamed: AFF3.6 (b), R24.2
unnamed: AFF3.4 (c), R25.2
unnamed: AFF3.2 (d), R26.2
unnamed: AFF3.1 (e), R27.2
unnamed: AFF3.9 (f), R28.2
unnamed: AFF3.10 (g), R29.2
unnamed: AFF7.7 (a), R51.2
unnamed: AFF7.6 (b), R52.2
unnamed: Q13.1 (B), R60.2
unnamed: Q15.1 (B), R61.2
unnamed: Q16.1 (B), R62.2
unnamed: Q14.1 (B), R63.2
unnamed: Q12.1 (B), R64.2
unnamed: Q10.1 (B), R65.2
unnamed: Q11.1 (B), R59.2
unnamed: Q9.1 (B), R58.2
unnamed: R59.1, U3.1 (QB)
unnamed: R60.1, U3.2 (QC)
unnamed: R61.1, U3.3 (QD)
unnamed: R62.1, U3.4 (QE)
unnamed: R63.1, U3.5 (QF)
unnamed: R64.1, U3.6 (QG)
unnamed: R65.1, U3.7 (QH)
unnamed: R58.1, U3.15 (QA)
unnamed: Q1.1 (B), R15.2
unnamed: Q3.1 (B), R16.2
unnamed: Q5.1 (B), R17.2
unnamed: R19.1, U1.4 (QE)
unnamed: Q8.1 (B), R19.2
unnamed: R20.1, U1.5 (QF)
unnamed: Q6.1 (B), R20.2
unnamed: R21.1, U1.6 (QG)
unnamed: Q4.1 (B), R21.2
unnamed: R22.1, U1.7 (QH)
unnamed: Q2.1 (B), R22.2
unnamed: R15.1, U1.15 (QA)
unnamed: R16.1, U1.1 (QB)
unnamed: R17.1, U1.2 (QC)
unnamed: R18.1, U1.3 (QD)
unnamed: Q7.1 (B), R18.2
unnamed: AFF5.6 (b), R38.2
unnamed: AFF2.10 (g), R14.2
unnamed: AFF2.7 (a), R8.2
unnamed: AFF2.6 (b), R9.2
unnamed: AFF2.4 (c), R10.2
unnamed: AFF2.2 (d), R11.2
unnamed: AFF2.1 (e), R12.2
unnamed: AFF2.9 (f), R13.2
unnamed: AFF4.1 (e), R34.2
unnamed: AFF4.2 (d), R33.2
unnamed: AFF4.4 (c), R32.2
unnamed: AFF4.6 (b), R31.2
unnamed: AFF4.7 (a), R30.2
unnamed: AFF4.9 (f), R35.2
unnamed: AFF4.10 (g), R36.2
unnamed: AFF5.7 (a), R37.2
unnamed: AFF6.7 (a), R44.2
unnamed: AFF6.6 (b), R45.2
unnamed: AFF6.4 (c), R46.2
unnamed: AFF6.2 (d), R47.2
unnamed: AFF6.1 (e), R48.2
unnamed: AFF6.9 (f), R49.2
unnamed: AFF6.10 (g), R50.2
V3.3: C2.1, C3.1, U1.10 (SRCLR), U1.16 (VCC), U2.3, U2.VO, U3.10 (SRCLR), U3.16 (VCC)
VCC: C1.1, P1.2, Q2.3 (C), Q9.3 (C), Q10.3 (C), Q11.3 (C), Q12.3 (C), Q13.3 (C), Q14.3 (C), Q15.3 (C), Q16.3 (C), U2.2, U2.VI

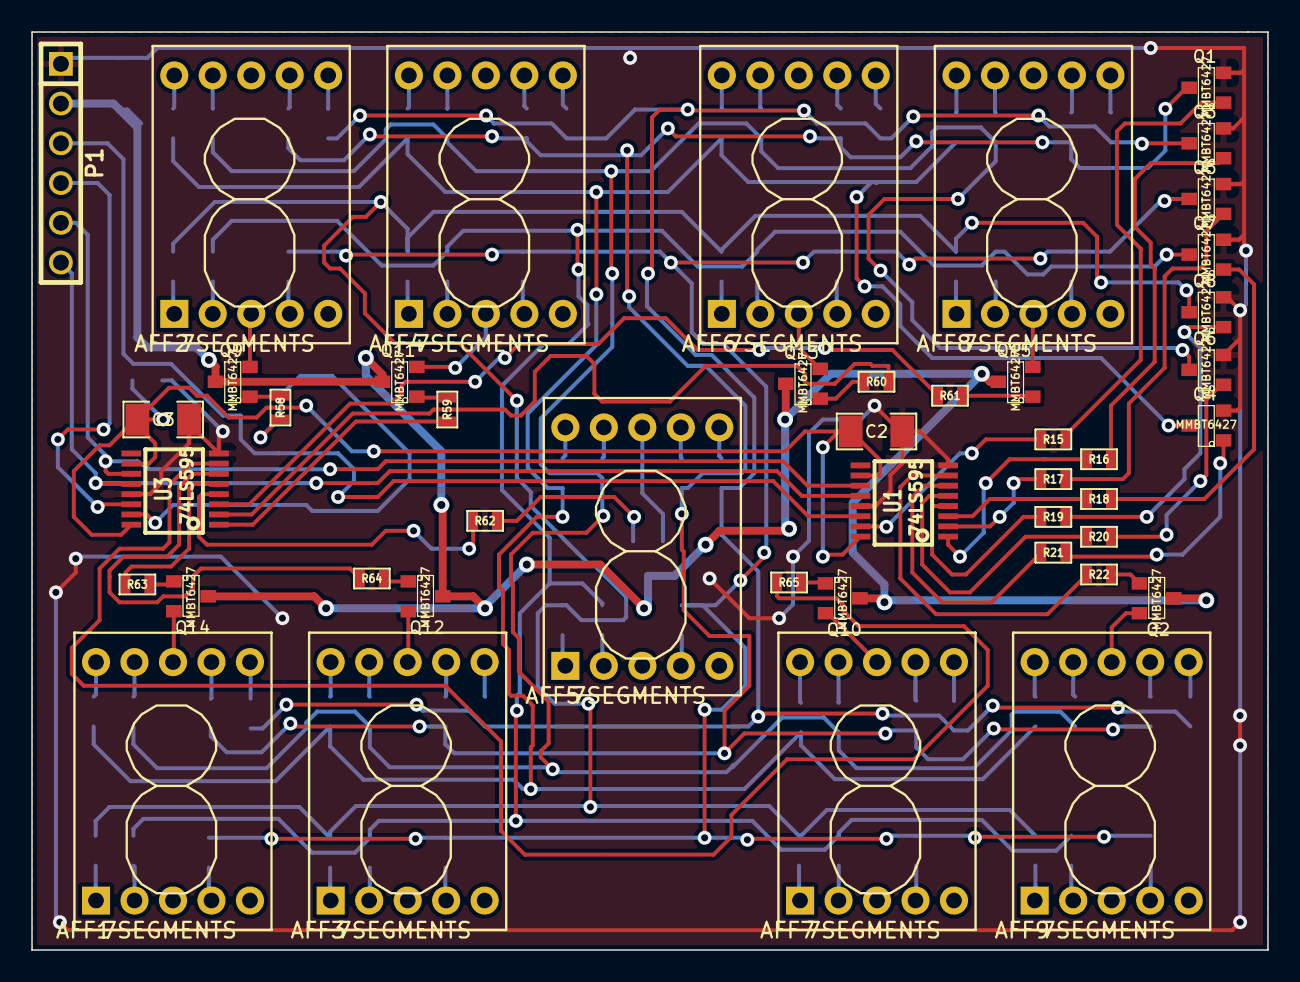
[picture p11: board TestDisplay.kicad_pcb from above]

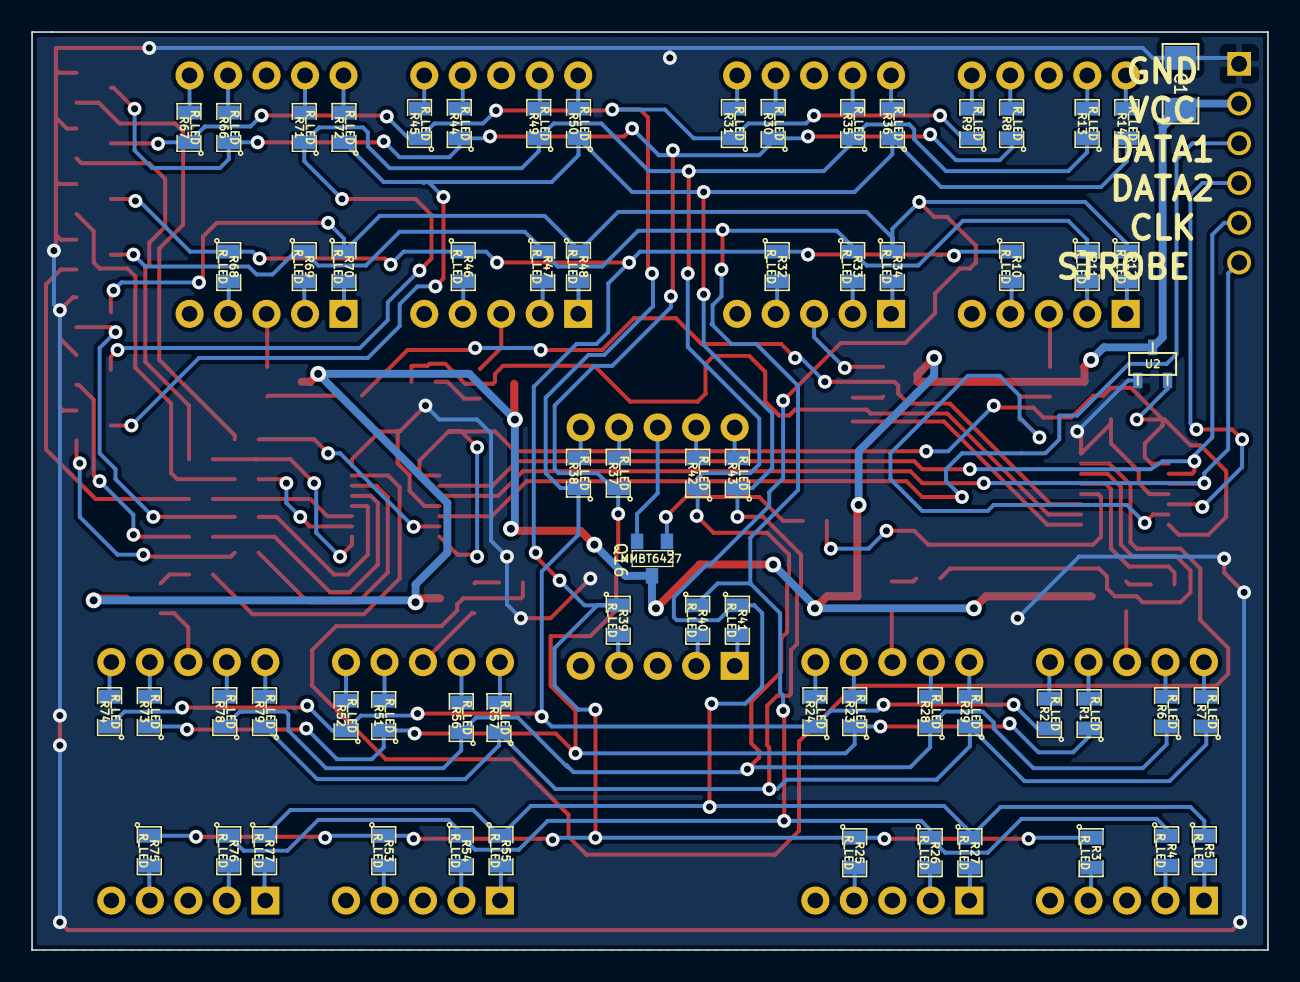
[picture p12: board TestDisplay.kicad_pcb from below]

Board: 2 copper layers, 79.0 x 58.7 mm, 111 parts (66 on the bottom side), 118 nets.
