kratz9/Scoreboard/PowerSupply/Scoreboard_PowerSupply.kicad_pcb

## KiCad design PowerSupply/Scoreboard_PowerSupply.kicad_pcb (2014-08-26)

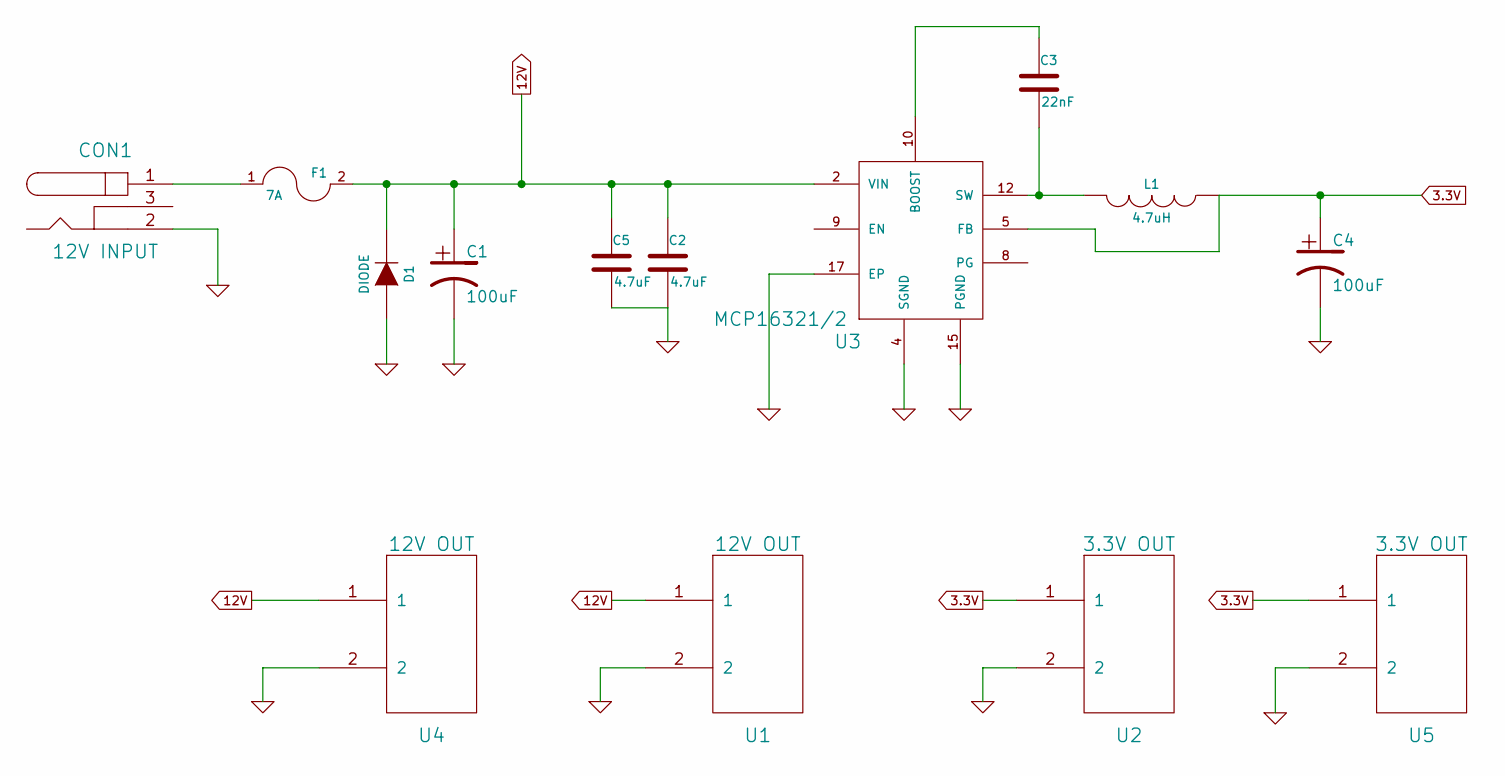
[picture p13: schematic Scoreboard_PowerSupply.sch]

Parts:
C1, C4: 100uF
C2, C5: 4.7uF
C3: 22nF
CON1: 12V INPUT
D1: DIODE
F1: 7A
L1: 4.7uH
U1, U4: 12V OUT
U2, U5: 3.3V OUT
U3: MCP16321/2

Connections:
3.3V: C4.1, L1.1, U2.1, U3.5 (FB), U5.1
12V: C1.1, C2.1, C5.1, D1.2 (K), F1.2, U1.1, U3.2 (VIN), U4.1
GND: C1.2, C2.2, C4.2, C5.2, CON1.2, D1.1 (A), U1.2, U2.2, U3.4 (SGND), U3.15 (PGND), U3.17 (EP), U4.2, U5.2
unnamed: C3.1, U3.10 (BOOST)
unnamed: C3.2, L1.2, U3.12 (SW)
unnamed: CON1.1, F1.1

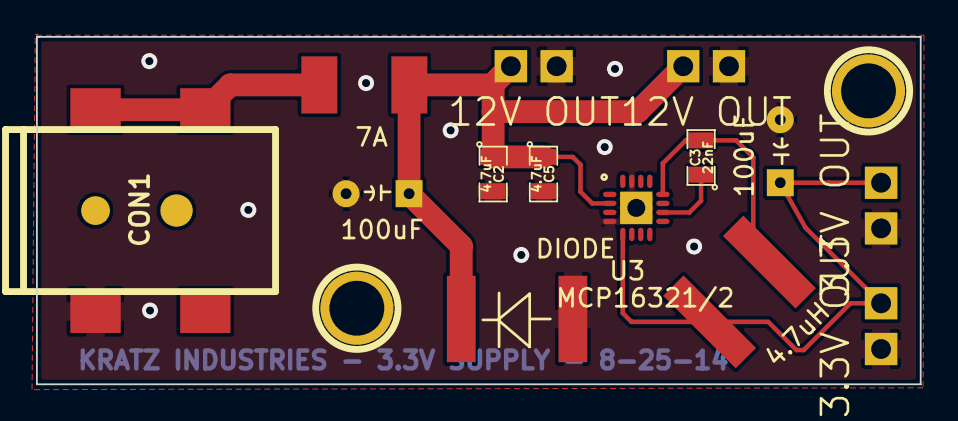
[picture p14: board Scoreboard_PowerSupply.kicad_pcb from above]

Board: 2 copper layers, 49.1 x 19.3 mm, 16 parts (0 on the bottom side), 6 nets.

Other parts of the board:
1PIN, 1PIN#2: P***; 1pin
