kratz9/Scoreboard/(commit log)

2014-08-21 Added System Diagram
    [$Scoreboard.sch, Scoreboard.sch]
2014-08-21 Made Sheets Started Driver Circuit
    [LED DRIVER.sch, LED LOW SIDE DRIVER.sch, PowerSupply.sch, Scoreboard.sch, WIFI_Controller.sch, noname.sch]
2014-08-23 Minor revisions and project stuff
    [$Scoreboard.sch, LED HIGH SIDE DRIVER.sch, PowerSupply.sch, Scoreboard.sch, WIFI_Controller.sch]
2014-08-25 8-24
    Started separating out the power supply and building the PCB
    [$Scoreboard_PowerSupply.sch, LED HIGH SIDE DRIVER.sch, LED LOW SIDE DRIVER.sch, Scoreboard.sch, Scoreboard_PowerSupply.kicad_pcb, Scoreboard_PowerSupply.sch, WIFI_Controller.sch, power_supply.kicad_pcb]
2014-08-26 8-25 10:02
    [Scoreboard_PowerSupply-B_Cu.gbl, Scoreboard_PowerSupply-B_Mask.gbs, Scoreboard_PowerSupply-B_SilkS.gbo, Scoreboard_PowerSupply-Edge_Cuts.gbr, Scoreboard_PowerSupply-F_Cu.gtl, Scoreboard_PowerSupply-F_Mask.gts, Scoreboard_PowerSupply-F_SilkS.gto, Scoreboard_PowerSupply.drl]
2014-09-05 9-4
    Changing the LED drive to Opto-coupled
    [High Side Drive.sch, LED Drive.sch, Low side drive.sch, LowSideIsolatedDrive.sch]
2014-09-26 Finallizing LED Driver
    [HighSideIsolatedDrive.sch, LED Drive.kicad_pcb, LED Drive.sch, LowSideIsolatedDrive.sch]
2014-09-26 Still finalizng LED Driver
    [LED Drive.kicad_pcb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]
2015-01-25 Test display start
    [LED DRIVER.sch, LED HIGH SIDE DRIVER.sch, LED LOW SIDE DRIVER.sch, PowerSupply.sch, Scoreboard.sch, TestDisplay.sch, WIFI_Controller.sch, noname.sch]
2015-01-26 Revert "Test display start"
    This reverts commit c1fec8fd228401c8c95fc62cf6add0c17674f68f.
    [LED DRIVER.sch, LED HIGH SIDE DRIVER.sch, LED LOW SIDE DRIVER.sch, PowerSupply.sch, Scoreboard.sch, TestDisplay.sch, WIFI_Controller.sch, noname.sch]
2015-01-26 Revert "Revert "Test display start""
    This reverts commit fc41cdbdcf2d1a7a8f10e923f753cbc016b450d2.
    [LED DRIVER.sch, LED HIGH SIDE DRIVER.sch, LED LOW SIDE DRIVER.sch, PowerSupply.sch, Scoreboard.sch, TestDisplay.sch, WIFI_Controller.sch, noname.sch]
2015-01-26 Test display
    [Scoreboard.kicad_pcb, TestDisplay.sch]
2015-02-01 Test Display Finished
    [LED Drive.kicad_pcb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]
2015-02-06 start of test digit
    [Digit.sch]
2015-02-06 Digit PCB
    [Digit-B_Cu.gbl, Digit-B_Mask.gbs, Digit-B_SilkS.gbo, Digit-Edge_Cuts.gbr, Digit-F_Cu.gtl, Digit-F_Mask.gts, Digit-F_SilkS.gto, Digit.drl]
2015-02-24 Digit Fixes
    [Digit-B_Cu.gbl, Digit-B_Mask.gbs, Digit-B_SilkS.gbo, Digit-Edge_Cuts.gbr, Digit-F_Cu.gtl, Digit-F_Mask.gts, Digit-F_SilkS.gto, Digit.drl]
2015-02-26 Solder Paste Layer Export
    [Digit-F_Paste.gtp]
